ZaqueuCavalcante/egbit/Diagram.png

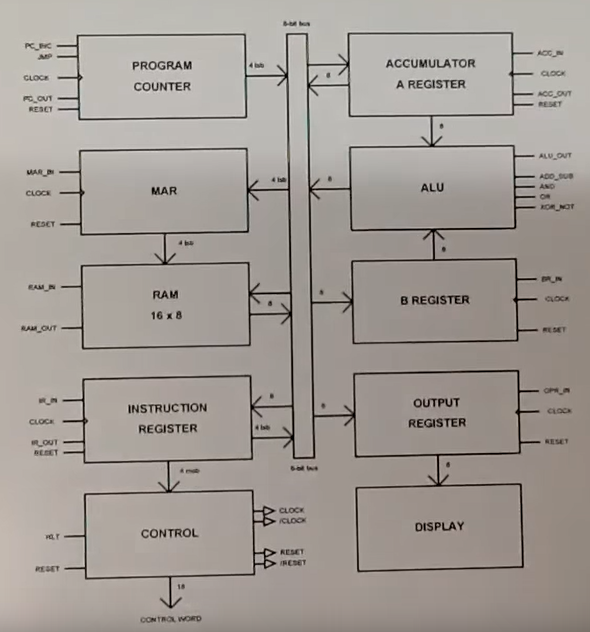
Diagram.png
