ZaqueuCavalcante/egbit/README.md

# Egbit

8 Bits Computer make from scratch.
