ZaqueuCavalcante/egbit/wr/8-bit_computer_00_WR_files/acc_register_list_WR_8-bit_computer.pdf

Bill Of Materials For ACC Register
Design Title | :ACC Register
Author | :<NONE>
Revision | :<NONE>
Design Created | :sexta-feira, 28 de julho de 2017
Design Last Modified:terça-feira, 15 de agosto de 2017 Total Parts In Design :22

8 Resistors

Quantity: | References | Value | Order Code
8 | R1-R8 | 470

3 Capacitors

Quantity: | References | Value | Order Code
3 | C1-C3 | 100nF

3 Integrated Circuits

Quantity: | References | Value | Order Code
2 | U1, U2 | 74LS173
1 | U3 | 74LS245

8 Diodes

Quantity: | References | Value | Order Code
8 | D1-D8 | LED

sexta-feira, 18 de agosto de 2017 18:22:33

Bill Of Materials For ACC Register | Página 1 de 1
file:///C:/Users/Usuário/AppData/Local/Temp/bom00001.HTM | 18/08/2017
