ZaqueuCavalcante/egbit/wr/8-bit_computer_00_WR_files/alu_list_WR_8-bit_computer.pdf

## Bill Of Materials For ALU

Design Title | :ALU
Author | | :<NONE>
Revision | | :<NONE>
Design Created | :terça-feira, 15 de agosto de 2017

### Design Last Modified:terça-feira, 29 de agosto de 2017 Total Parts In Design :50

### 8 Resistors

Quantity: | References | Value | Order Code
8 | R1-R8 | 470

### 17 Capacitors

Quantity: | References | Value | Order Code
17 | C1-C17 | 100nF

### 17 Integrated Circuits

Quantity: | References | Value | Order Code
2 | U1, U2 | 74LS283
4 | U3, U4, U10, U12 | 74LS86
2 | U5, U6 | 74LS08
4 | U7-U9, U11 | 74LS32
4 | U13-U16 | 74LS153
1 | U17 | 74LS245

### 8 Diodes

Quantity: | References | Value | Order Code
8 | D1-D8 | LED

sexta-feira, 15 de setembro de 2017 01:32:31

Bill Of Materials For ALU | Página 1 de 1
file:///C:/Users/Usuário/AppData/Local/Temp/bom00001.HTM | 15/09/2017
