ZaqueuCavalcante/egbit/wr/8-bit_computer_00_WR_files/clock_circuit_list_WR_8-bit_computer.pdf

## Bill Of Materials For Clock Circuit

Design Title | :Clock Circuit
Author | :<NONE>
Revision | :<NONE>
Design Created | :sexta-feira, 11 de agosto de 2017

### Design Last Modified:terça-feira, 15 de agosto de 2017 Total Parts In Design :19

### 5 Resistors

Quantity: | References | Value | Order Code
1 | R1 | 150
1 | R2 | 10
1 | R3 | 10k
1 | R4 | 330k
1 | R5 | 470

### 7 Capacitors

Quantity: | References | Value | Order Code
1 | C1 | 10uF | Maplin WW69A
2 | C2, C4 | 10nF
1 | C3 | 330nF
3 | C5-C7 | 100nF

### 3 Integrated Circuits

Quantity: | References | Value | Order Code
1 | U1 | NE556
1 | U2 | 74LS04
1 | U3 | 74LS00

### 1 Diodes

Quantity: | References | Value | Order Code
1 | D1 | LED

### 3 Miscellaneous

Quantity: | References | Value | Order Code
1 | CLK_MAN | buttom
1 | RV1 | 100k
1 | SW1 | SW-SPDT

terça-feira, 15 de agosto de 2017 00:34:17

Bill Of Materials For Clock Circuit | Página 1 de 1
file:///C:/Users/Usuário/AppData/Local/Temp/bom00001.HTM | 15/08/2017
