ZaqueuCavalcante/egbit/wr/8-bit_computer_00_WR_files/control_decoder_list_WR_8-bit_computer.pdf

Bill Of Materials For Control Decoder
Design Title | :Control Decoder
Author | :<NONE>
Revision | :<NONE>
Design Created | :sexta-feira, 28 de julho de 2017
Design Last Modified:segunda-feira, 30 de outubro de 2017 Total Parts In Design :6

3 Capacitors

Quantity: | References | Value | Order Code
3 | C1-C3 | 100nF

3 Integrated Circuits

Quantity: | References | Value | Order Code
3 | U1-U3 | 2816

segunda-feira, 30 de outubro de 2017 23:34:38

Bill Of Materials For Control Decoder | Página 1 de 1
file:///C:/Users/Usuário/AppData/Local/Temp/bom00001.HTM | 30/10/2017
