ZaqueuCavalcante/egbit/wr/8-bit_computer_00_WR_files/control_word_list_WR_8-bit_computer.pdf

Bill Of Materials For Control Word
Design Title | :Control Word
Author | :<NONE>
Revision | :<NONE>
Design Created | :sexta-feira, 28 de julho de 2017
Design Last Modified:quinta-feira, 26 de outubro de 2017 Total Parts In Design :40

18 Resistors

Quantity: | References | Value | Order Code
18 | R1-R18 | 3k

2 Capacitors

Quantity: | References | Value | Order Code
2 | C1, C2 | 100nF

2 Integrated Circuits

Quantity: | References | Value | Order Code
2 | U1, U2 | 74LS04

18 Diodes

Quantity: | References | Value | Order Code
18 | D1-D18 | LED

segunda-feira, 30 de outubro de 2017 23:36:12

Bill Of Materials For Control Word | Página 1 de 1
file:///C:/Users/Usuário/AppData/Local/Temp/bom00001.HTM | 30/10/2017
