ZaqueuCavalcante/egbit/wr/8-bit_computer_00_WR_files/Cores e tamanhos dos LEDs de cada circuito.pdf

Cores e tamanhos dos LEDs de cada circuito

ACC Register: 8 LEDs vermelhos 3mm difusos;

ALU: 8 LEDs vermelhos 3mm difusos;

B Register: 8 LEDs vermelhos 3mm difusos;

Clock Circuit: 1 LED verde 5mm difuso;

Control Word: 18 LEDs azuis 3mm difusos;

Fetch Execution Counter: 3 LEDs amarelos 3mm difusos e 5 LEDs verdes 3mm difusos;

Instruction Register: 4 LEDs verdes 3mm difusos e 4 LEDs vermelhos 3mm difusos;

Output Register: 8 LEDs amarelos 3mm difusos;

Program Counter: 4 LEDs verdes 3mm difusos;

RAM & MAR: 4 LEDs amarelos 3mm difusos, 9 LEDs vermelhos 3mm difusos e 1 LED verde 3mm difuso;

BUS: 8 LEDs azuis 3mm difusos.
