ZaqueuCavalcante/egbit/wr/8-bit_computer_00_WR_files/decimal_display_list_WR_8-bit_computer.pdf

## Bill Of Materials For Decimal Display

Design Title | :Decimal Display
Author | :<NONE>
Revision | :<NONE>
Design Created | :sexta-feira, 28 de julho de 2017

### Design Last Modified:quinta-feira, 28 de setembro de 2017 Total Parts In Design :13

### 2 Resistors

Quantity: | References | Value | Order Code
1 | R1 | 1k
1 | R2 | 100k

### 5 Capacitors

Quantity: | References | Value | Order Code
3 | C1-C3 | 100nF
1 | C4 | 15nF
1 | C5 | 10nF

### 4 Integrated Circuits

Quantity: | References | Value | Order Code
1 | U1 | 2816
1 | U2 | 555
1 | U3 | 74LS161
1 | U4 | 74LS139

### 2 Miscellaneous

Quantity: | References | Value | Order Code
1 | DISPLAY | XDMR14C4-1A
1 | SW1 | SW-SPDT

quinta-feira, 28 de setembro de 2017 15:53:52

Bill Of Materials For Decimal Display | Página 1 de 1
file:///C:/Users/Usuário/AppData/Local/Temp/bom00001.HTM | 28/09/2017
