ZaqueuCavalcante/egbit/wr/8-bit_computer_00_WR_files/fetch_execution_counter_list_WR_8-bit_computer.pdf

Bill Of Materials For Fetch Execution Counter
Design Title | :Fetch Execution Counter
Author | :<NONE>
Revision | :<NONE>
Design Created | :sexta-feira, 28 de julho de 2017
Design Last Modified:quarta-feira, 4 de outubro de 2017 Total Parts In Design :15

3 Resistors

Quantity: | References | Value | Order Code
3 | R2, R3, R9 | 330

2 Capacitors

Quantity: | References | Value | Order Code
2 | C1, C2 | 100nF

2 Integrated Circuits

Quantity: | References | Value | Order Code
1 | U1 | 74LS161
1 | U2 | 74LS138

8 Diodes

Quantity: | References | Value | Order Code
8 | D1-D8 | LED

quarta-feira, 4 de outubro de 2017 17:11:42

Bill Of Materials For Fetch Execution Counter | Página 1 de 1
file:///C:/Users/Usuário/AppData/Local/Temp/bom00001.HTM | 04/10/2017
