ZaqueuCavalcante/egbit/wr/8-bit_computer_00_WR_files/output_register_list_WR_8-bit_computer.pdf

Bill Of Materials For Output Register
Design Title | :Output Register
Author | :<NONE>
Revision | :<NONE>
Design Created | :sexta-feira, 28 de julho de 2017
Design Last Modified:sexta-feira, 22 de setembro de 2017 Total Parts In Design :20

8 Resistors

Quantity: | References | Value | Order Code
8 | R1-R8 | 150

2 Capacitors

Quantity: | References | Value | Order Code
2 | C1, C2 | 100nF

2 Integrated Circuits

Quantity: | References | Value | Order Code
2 | U1, U2 | 74LS173

8 Diodes

Quantity: | References | Value | Order Code
8 | D1-D8 | LED

segunda-feira, 25 de setembro de 2017 12:48:52

Bill Of Materials For Output Register | Página 1 de 1
file:///C:/Users/Usuário/AppData/Local/Temp/bom00001.HTM | 25/09/2017
