ZaqueuCavalcante/egbit/wr/8-bit_computer_00_WR_files/program_counter_list_WR_8-bit_computer.pdf

Bill Of Materials For Program Counter
Design Title | :Program Counter
Author | :<NONE>
Revision | :<NONE>
Design Created | :terça-feira, 15 de agosto de 2017
Design Last Modified:terça-feira, 15 de agosto de 2017 Total Parts In Design :12

4 Resistors

Quantity: | References | Value | Order Code
4 | R1-R4 | 470

2 Capacitors

Quantity: | References | Value | Order Code
2 | C1, C2 | 100nF

2 Integrated Circuits

Quantity: | References | Value | Order Code
1 | U1 | 74LS161
1 | U2 | 74LS245

4 Diodes

Quantity: | References | Value | Order Code
4 | D1-D4 | LED

terça-feira, 15 de agosto de 2017 17:18:45

Bill Of Materials For Program Counter | Página 1 de 1
file:///C:/Users/Usuário/AppData/Local/Temp/bom00001.HTM | 15/08/2017
