ZaqueuCavalcante/egbit/wr/8-bit_computer_00_WR_files/reset_circuit_list_WR_8-bit_computer.pdf

Bill Of Materials For Reset Circuit
Design Title | :Reset Circuit
Author | :<NONE>
Revision | :<NONE>
Design Created | :sexta-feira, 28 de julho de 2017
Design Last Modified:sábado, 23 de setembro de 2017 Total Parts In Design :4

1 Resistors

Quantity: | References | Value | Order Code
1 | R1 | 10k

1 Capacitors

Quantity: | References | Value | Order Code
1 | C1 | 100nF

1 Integrated Circuits

Quantity: | References | Value | Order Code
1 | U1 | 74LS00

1 Miscellaneous

Quantity: | References | Value | Order Code
1 | BT_RST

segunda-feira, 25 de setembro de 2017 12:51:08

Bill Of Materials For Reset Circuit | Página 1 de 1
file:///C:/Users/Usuário/AppData/Local/Temp/bom00001.HTM | 25/09/2017
