ZaqueuCavalcante/egbit/wr/8-bit_computer_00_WR_files/other_components_and_parts_list_WR_8-bit.pdf

Bill Of Materials For Other Components And Parts
Design Title | :Other Components and Parts
Author | | :<NONE>
Revision | | :<NONE>
Design Created | :sexta-feira, 28 de julho de 2017
Design Last Modified:segunda-feira, 30 de outubro de 2017 Total Parts In Design :37

8 Resistors

Quantity: | References | Value | Order Code
8 | R1-R8 | 1k

8 Diodes

Quantity: | References | Value | Order Code
8 | D1-D8 | LED

21 Miscellaneous

Quantity: | References | Value | Order Code
18 | OT1-OT18 | PROTOBOARD
1 | OT19 | MUITOS FIOS 22AWG
1 | OT20 | CHAPA_PVC 37X37CM
1 | RP1 | RESPACK-8x10k

segunda-feira, 30 de outubro de 2017 23:55:25

Bill Of Materials For Other Components and Parts | Página 1 de 1
file:///C:/Users/Usuário/AppData/Local/Temp/bom00001.HTM | 30/10/2017
