ZaqueuCavalcante/egbit/00_clock_circuit.PDF

U1:A

U1:B

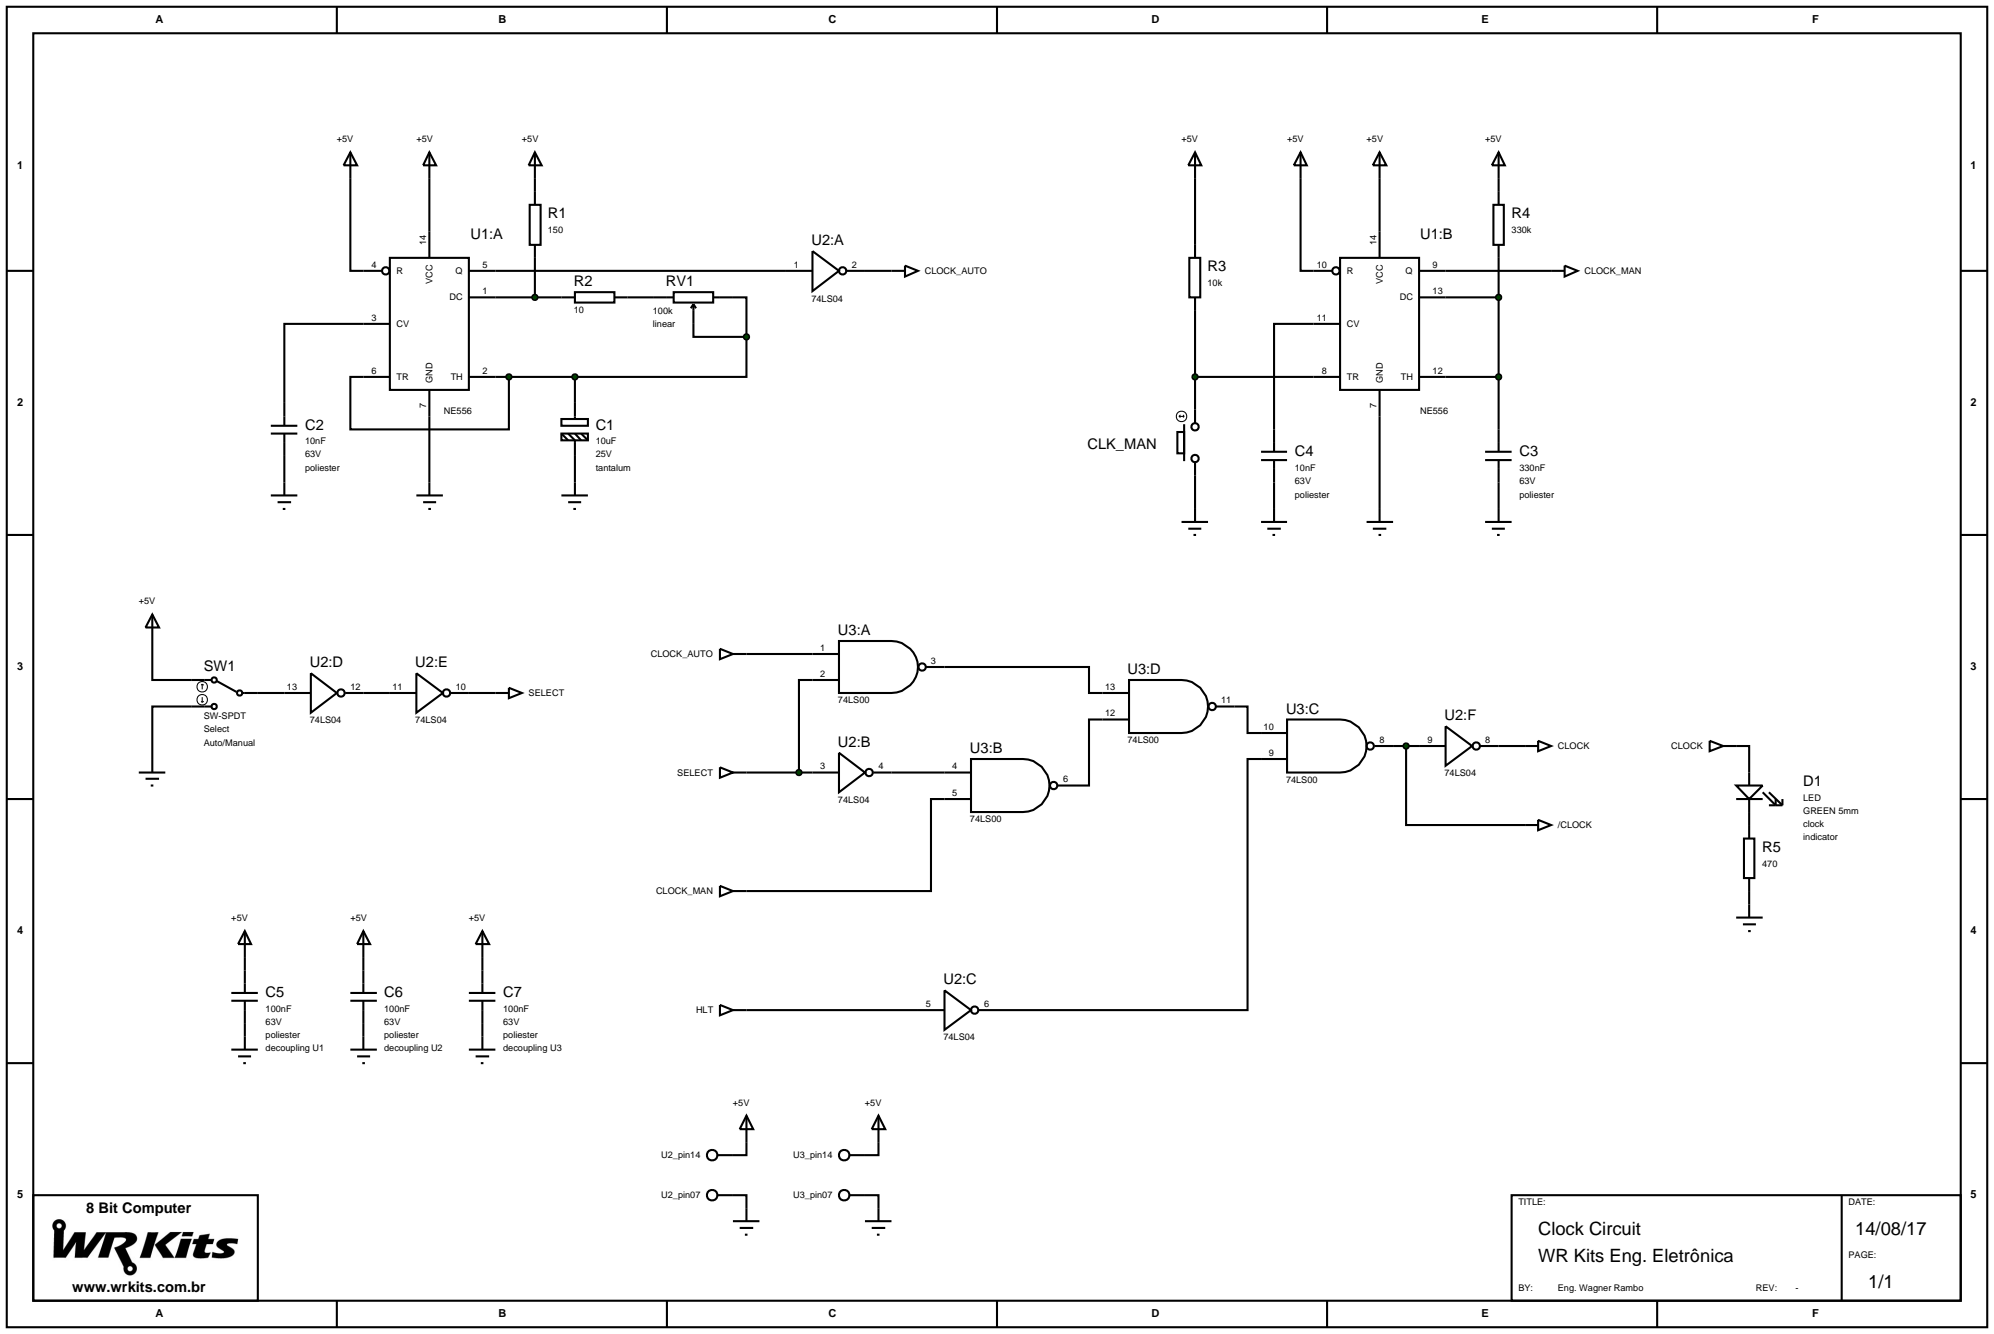
[picture p5: page 1]

TITLE:
Clock Circuit
WR Kits Eng. Eletrônica

www.wrkits.com.br
