ZaqueuCavalcante/egbit/reset_circuit_WR_8-bit_computer.PDF

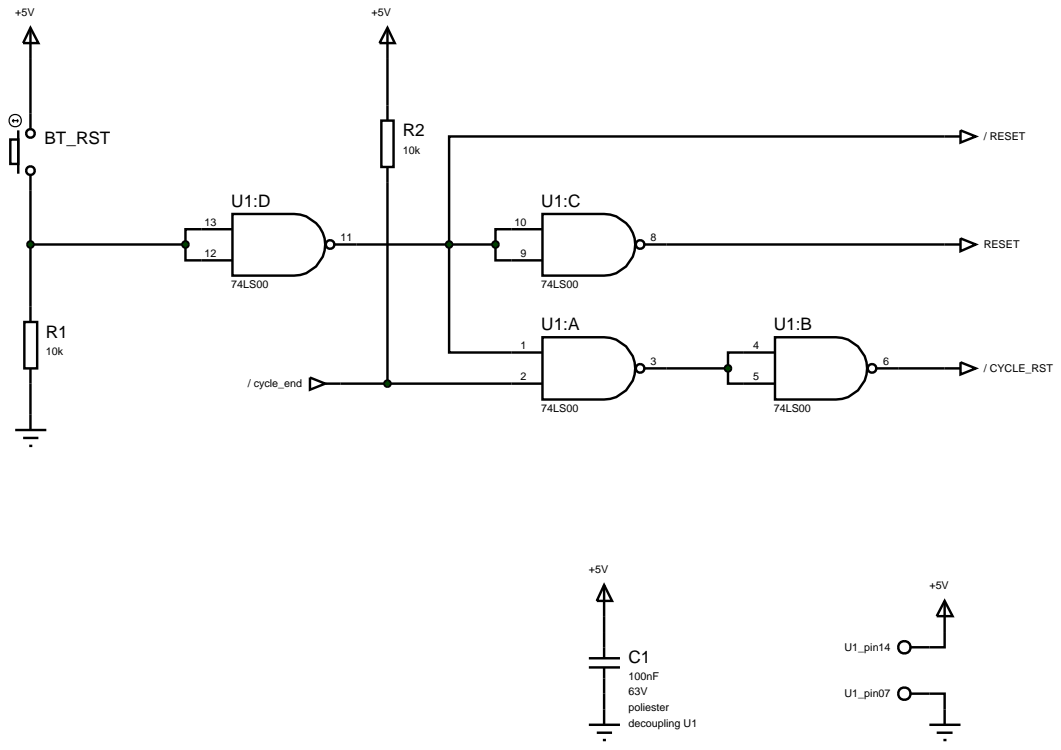
[picture p6: page 1]
DATE:; PAGE:; Eng. Wagner Rambo; REV:; 8 Bit Computer; 100nF 63V poliester decoupling U1; RESET; / RESET; / CYCLE_RST; / cycle_end; BT_RST; U1_pin14; U1_pin07

TITLE:
Reset Circuit
WR Kits Eng. Eletrônica

www.wrkits.com.br
