ZaqueuCavalcante/egbit/wr/8-bit_computer_02_WR_files/clock_circuit_WR_8-bit_computer.PDF

U1:A

U1:B


TITLE:
Clock Circuit
WR Kits Eng. Eletrônica

www.wrkits.com.br
