ZaqueuCavalcante/egbit/04_instruction_register.PDF

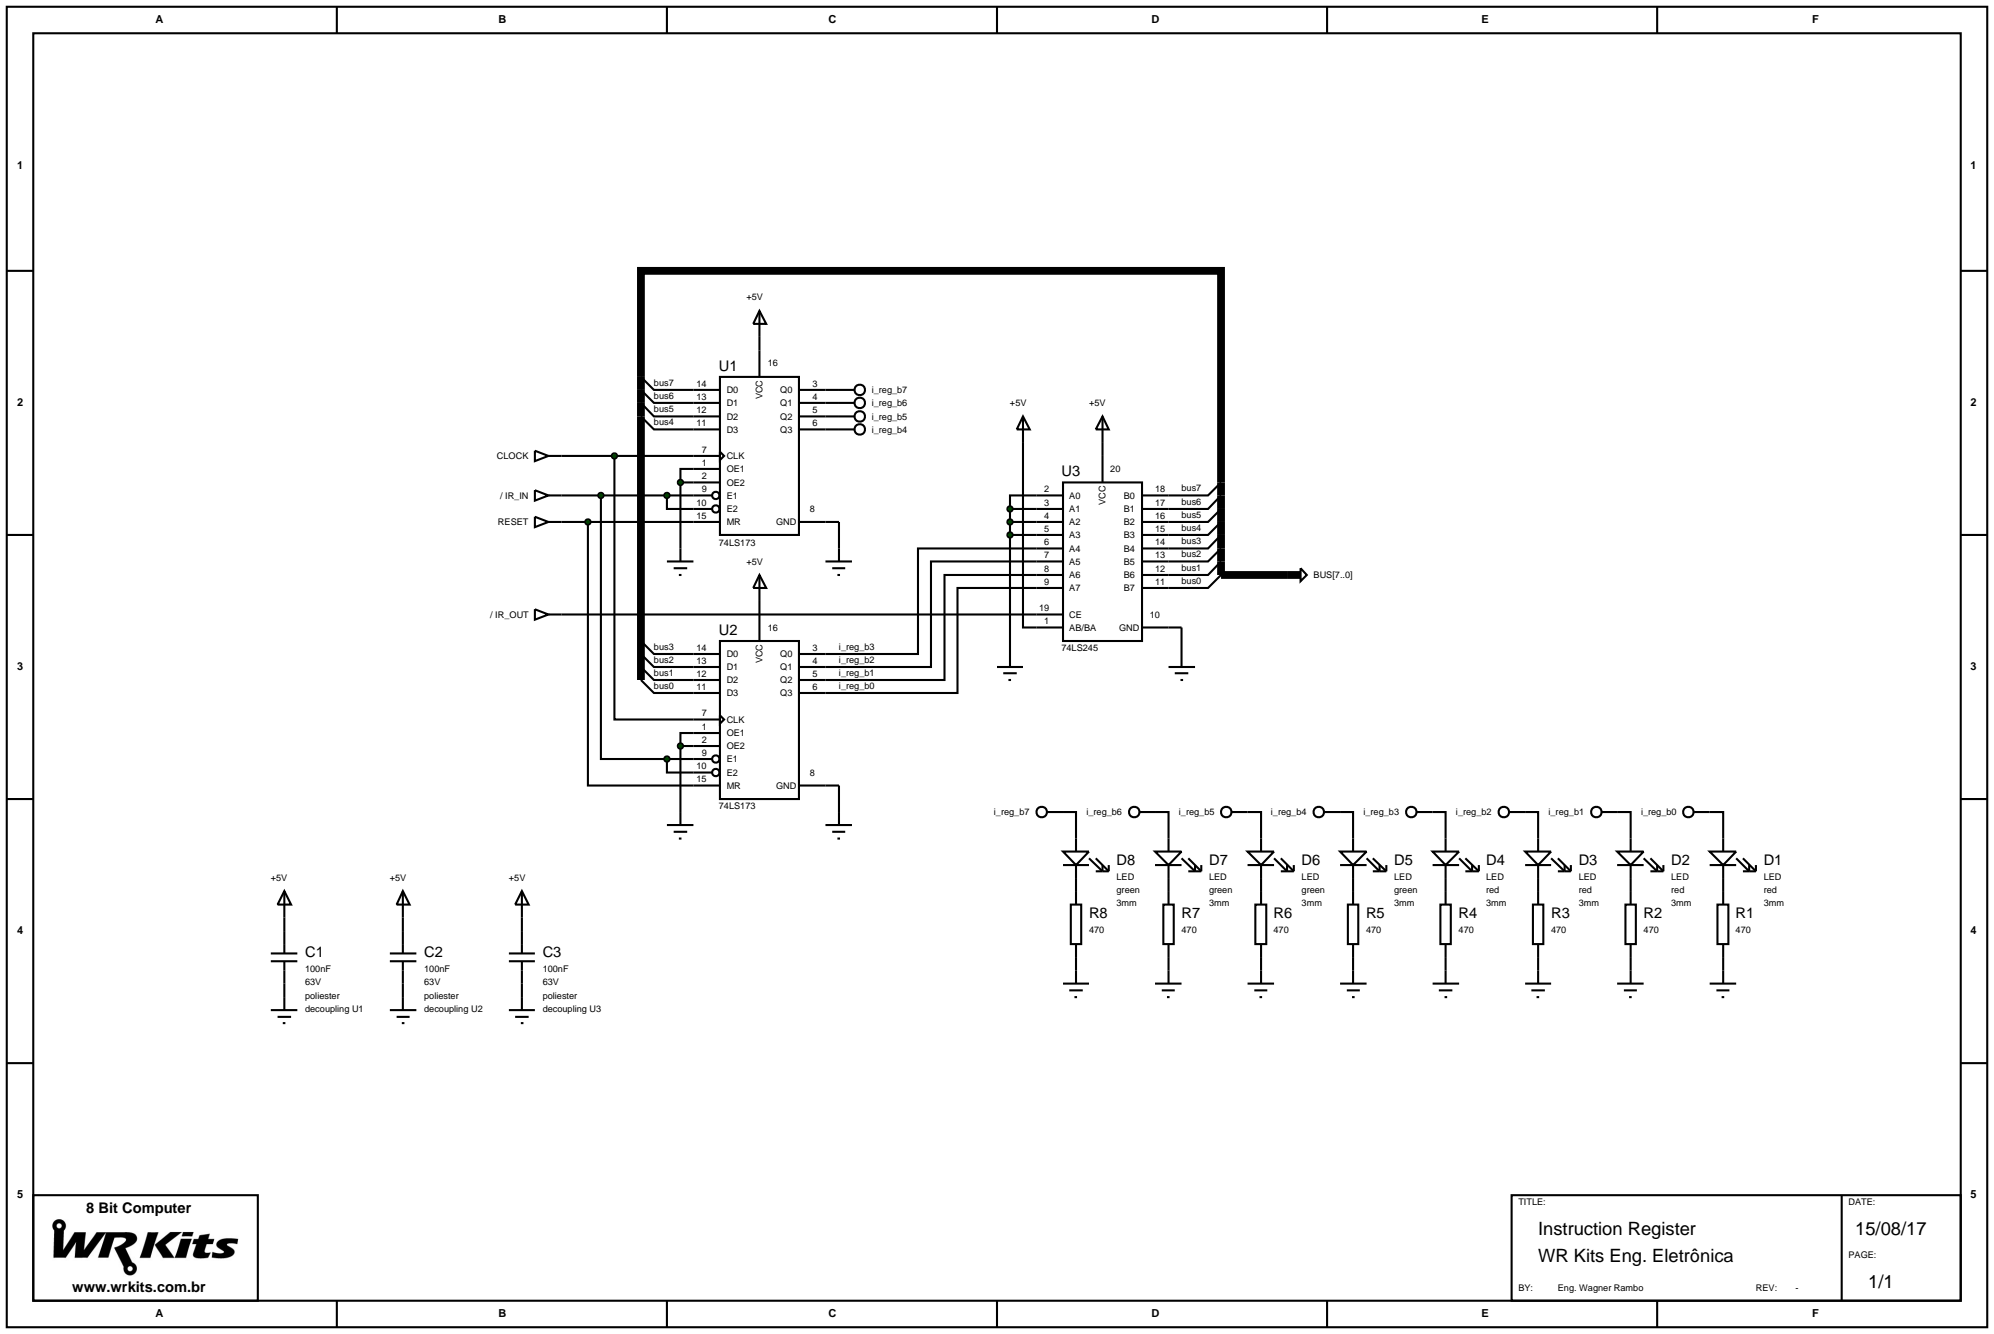
[picture p7: page 1]

TITLE:
Instruction Register
WR Kits Eng. Eletrônica

www.wrkits.com.br
