ZaqueuCavalcante/egbit/02_acc_register.PDF

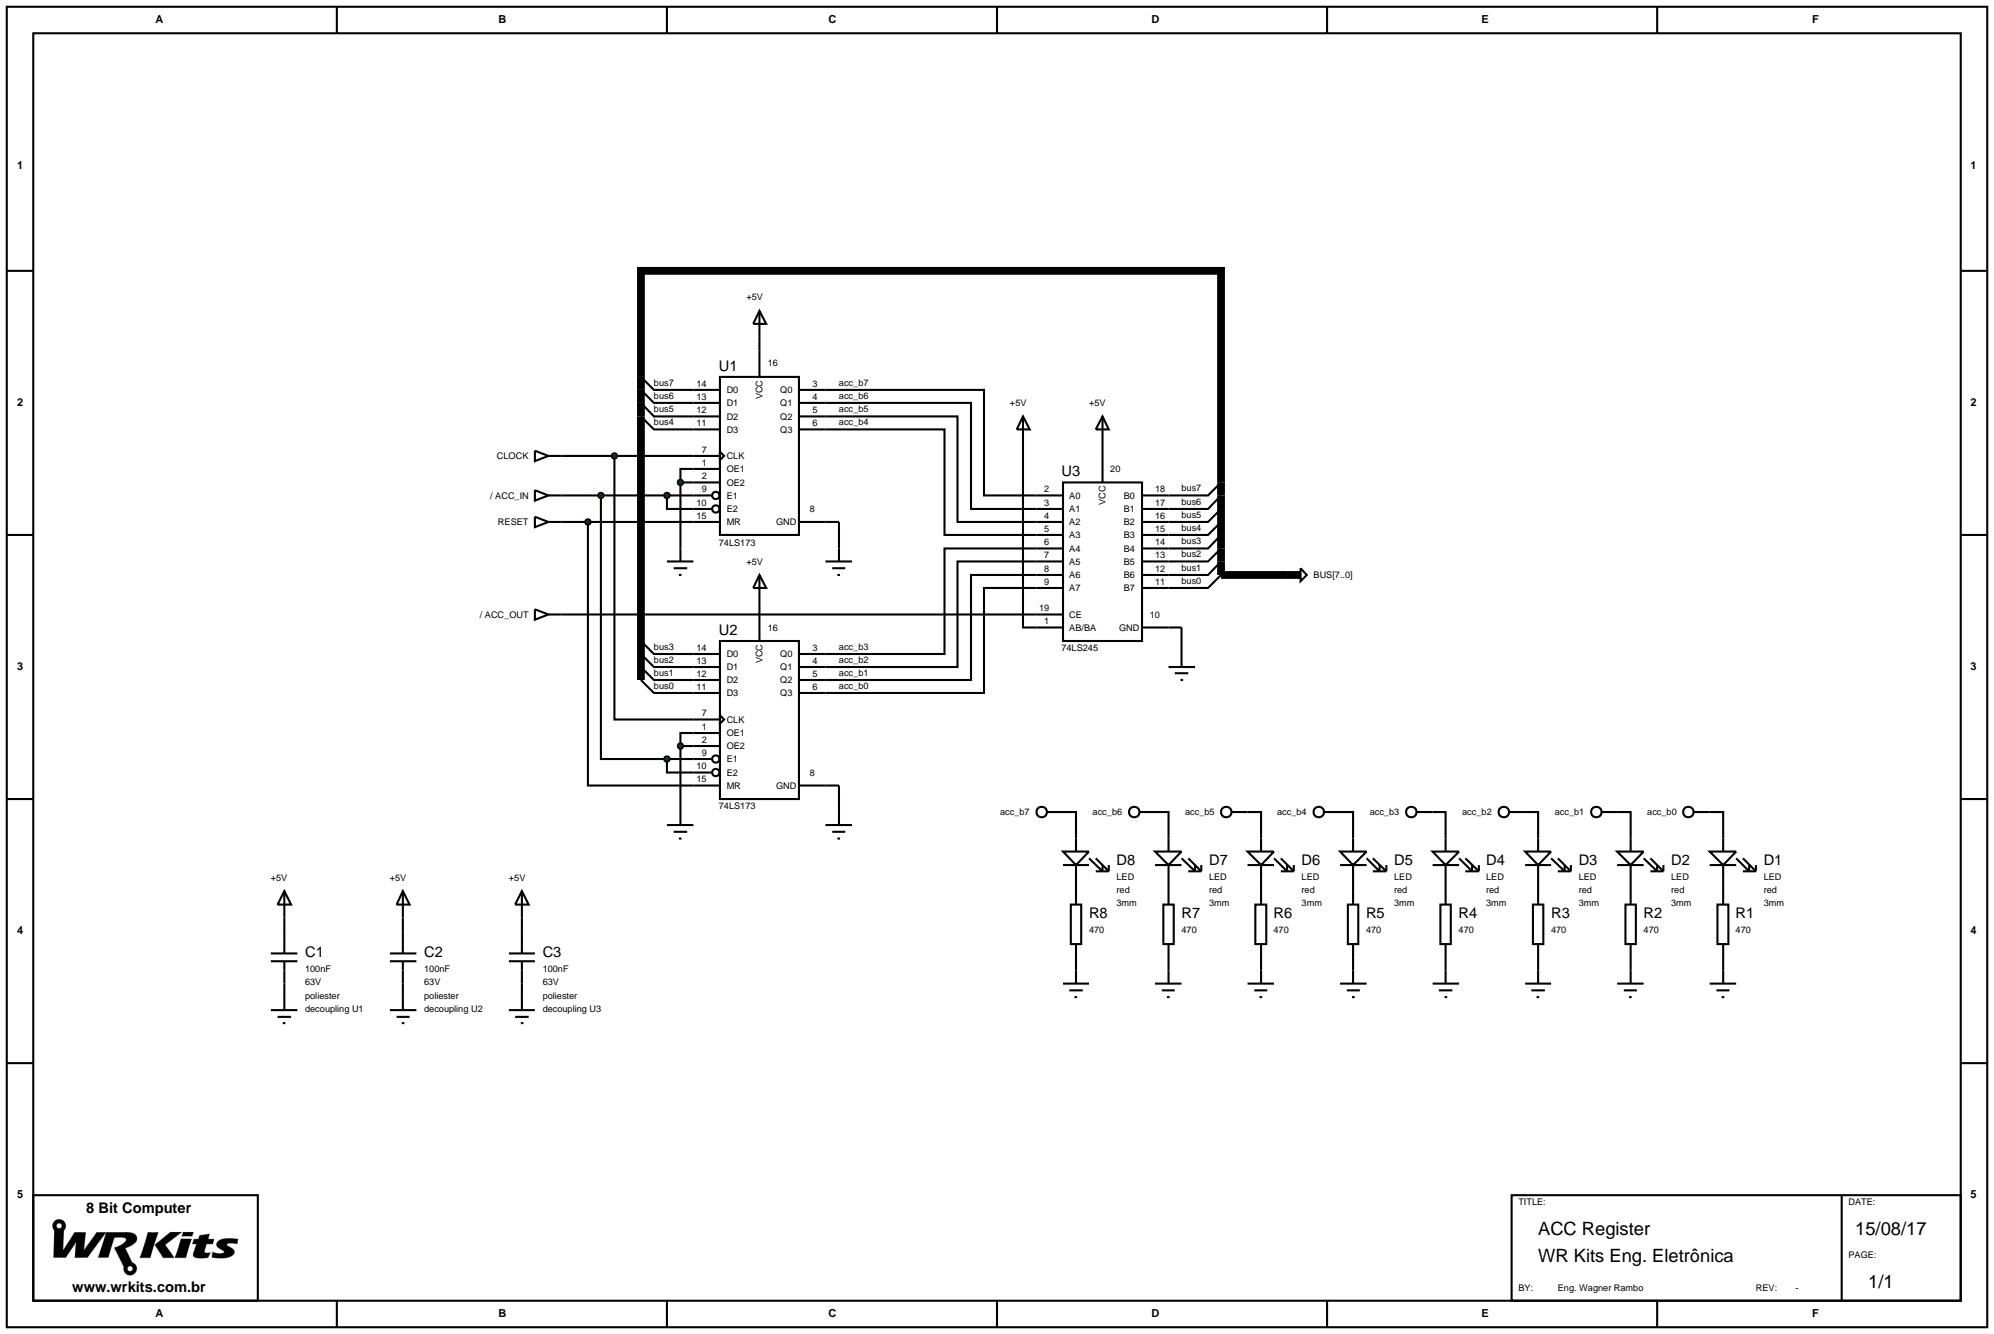
[picture p8: page 1]

TITLE:
ACC Register
WR Kits Eng. Eletrônica

www.wrkits.com.br
