ZaqueuCavalcante/egbit/03_b_register.PDF

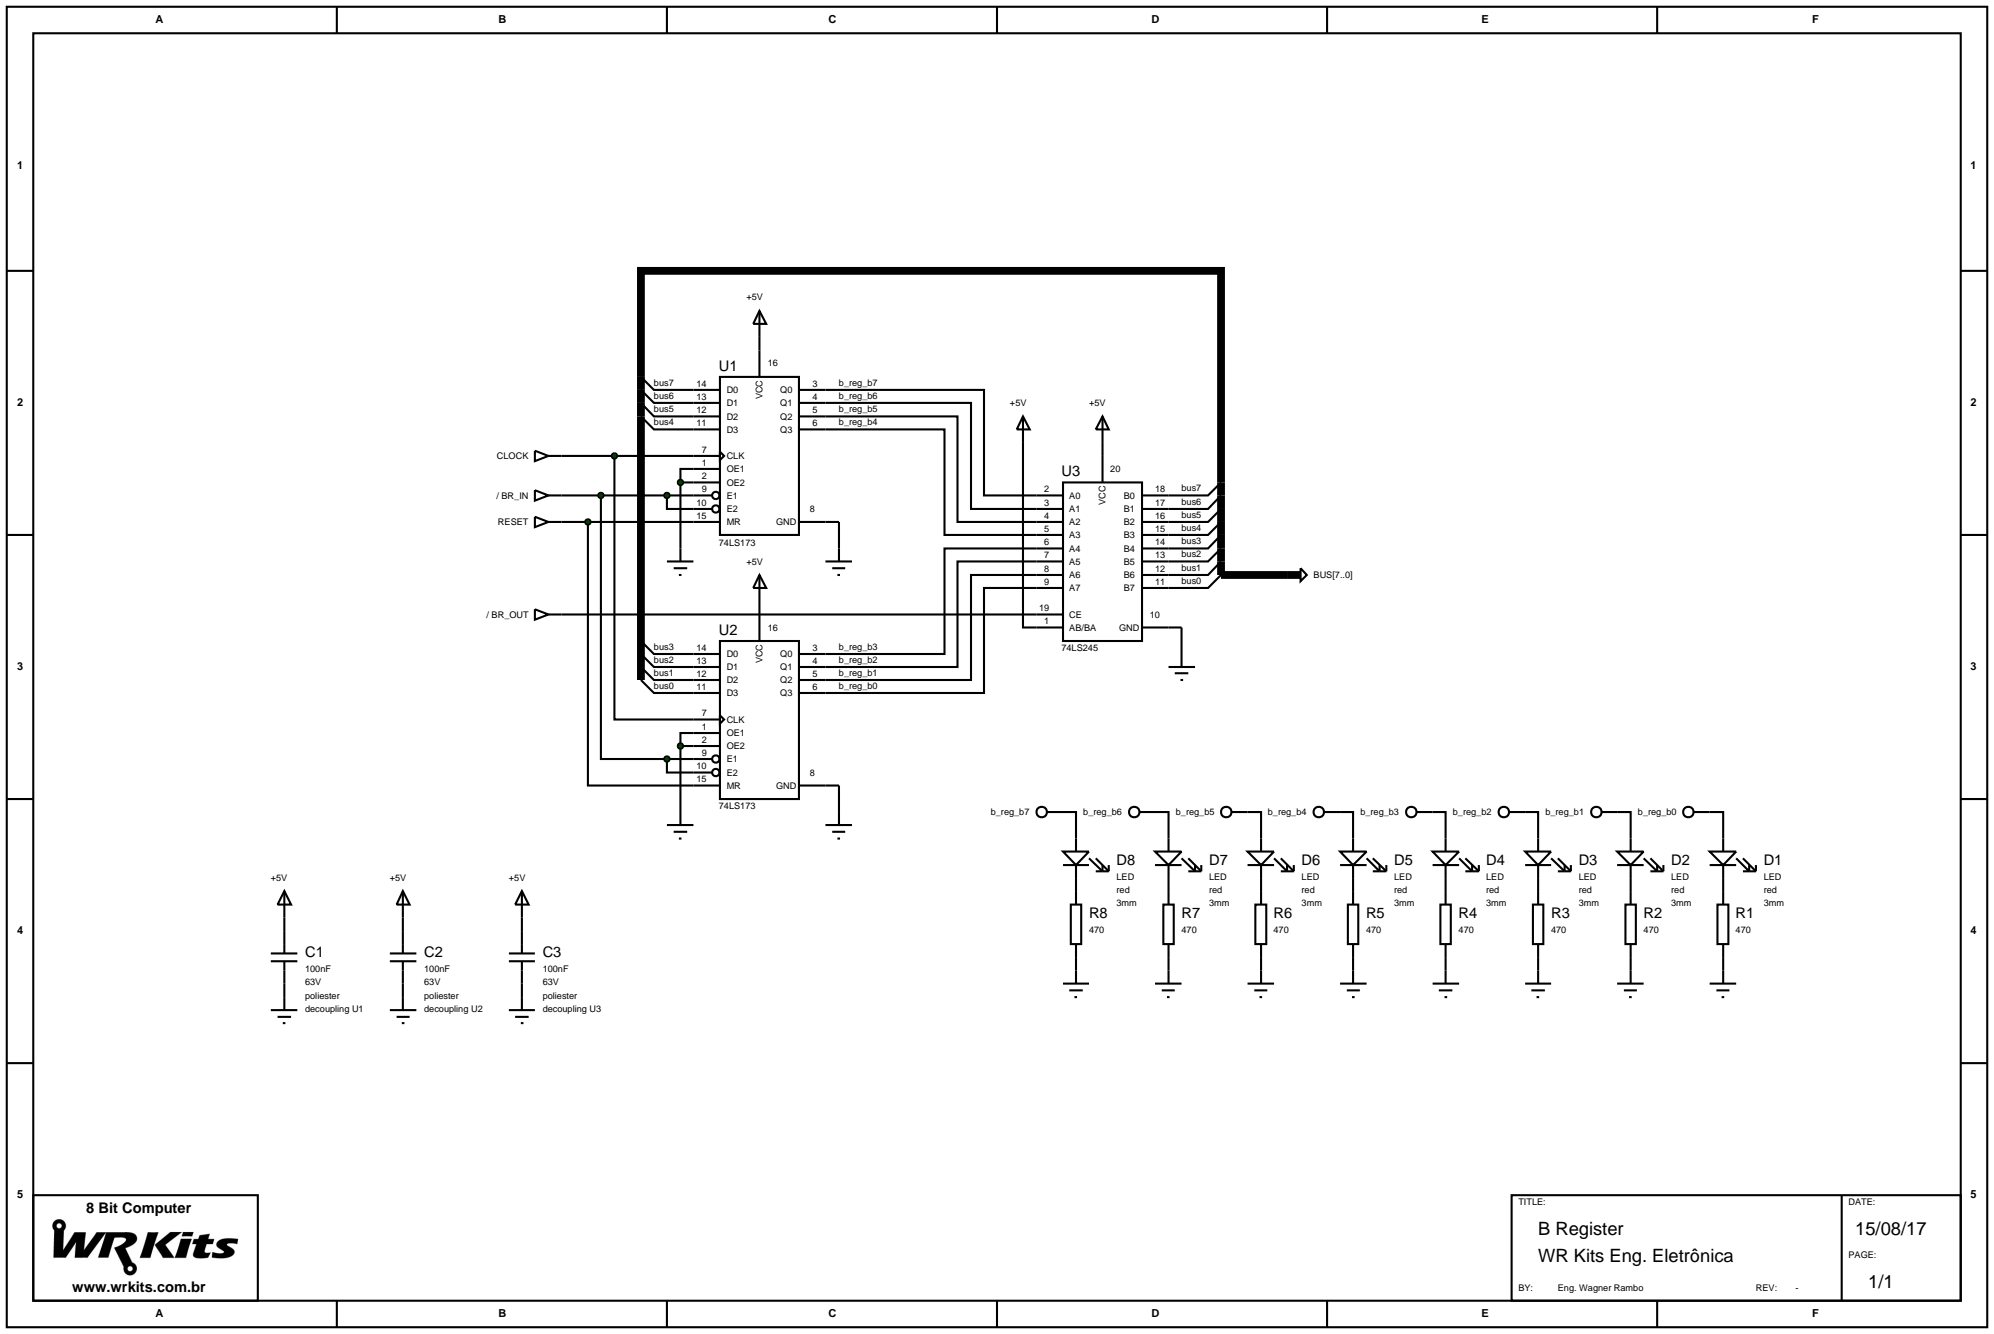
[picture p9: page 1]

TITLE:
B Register
WR Kits Eng. Eletrônica

www.wrkits.com.br
