ZaqueuCavalcante/egbit/05_alu.PDF

U1

U2

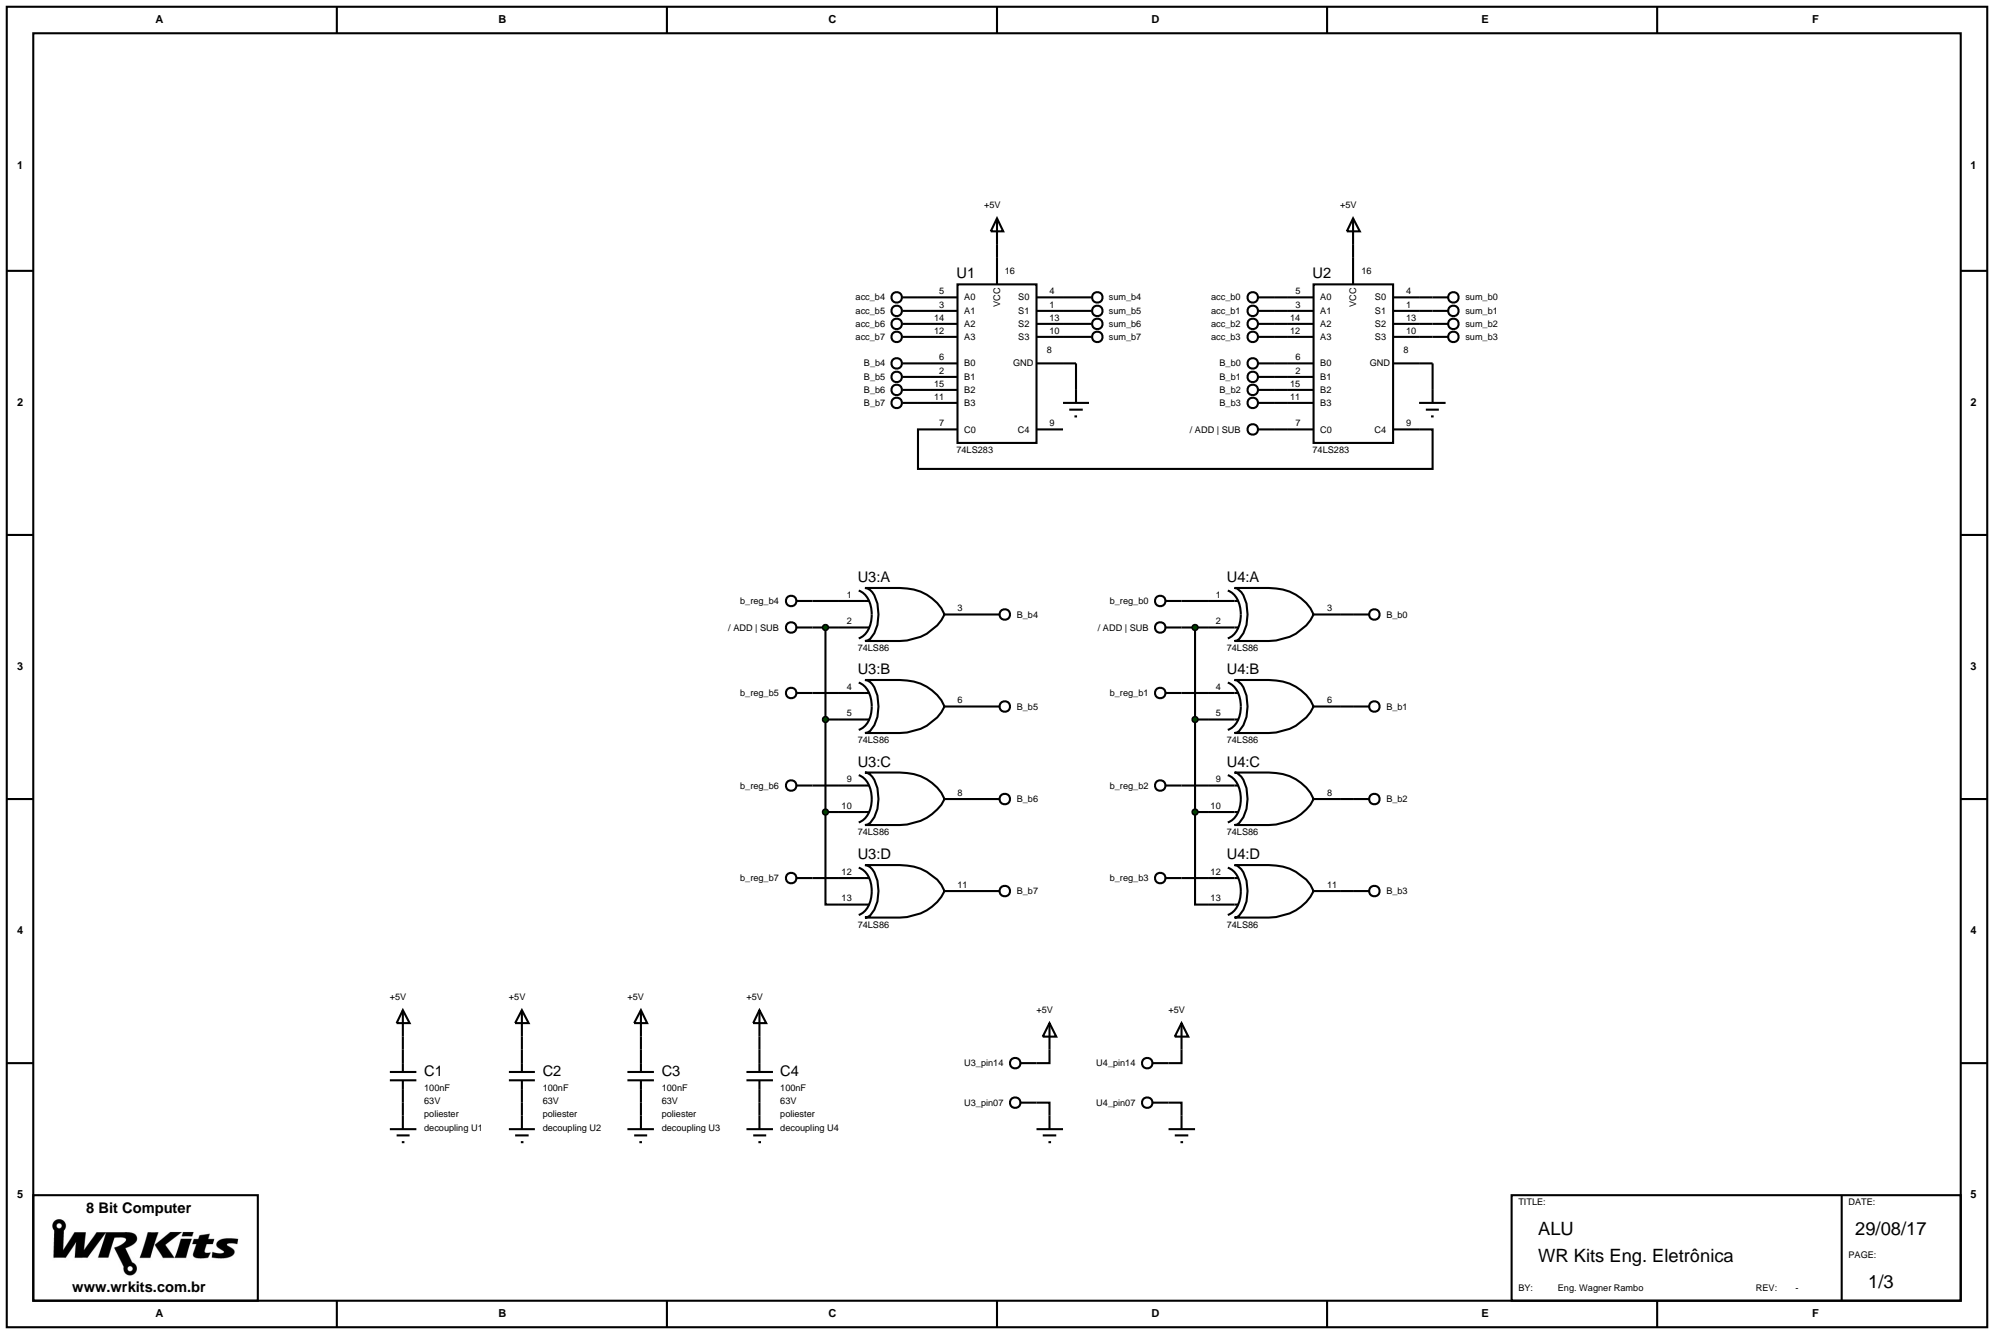
[picture p10: page 1]

TITLE:
ALU
WR Kits Eng. Eletrônica

www.wrkits.com.br

U5:A

U5:B

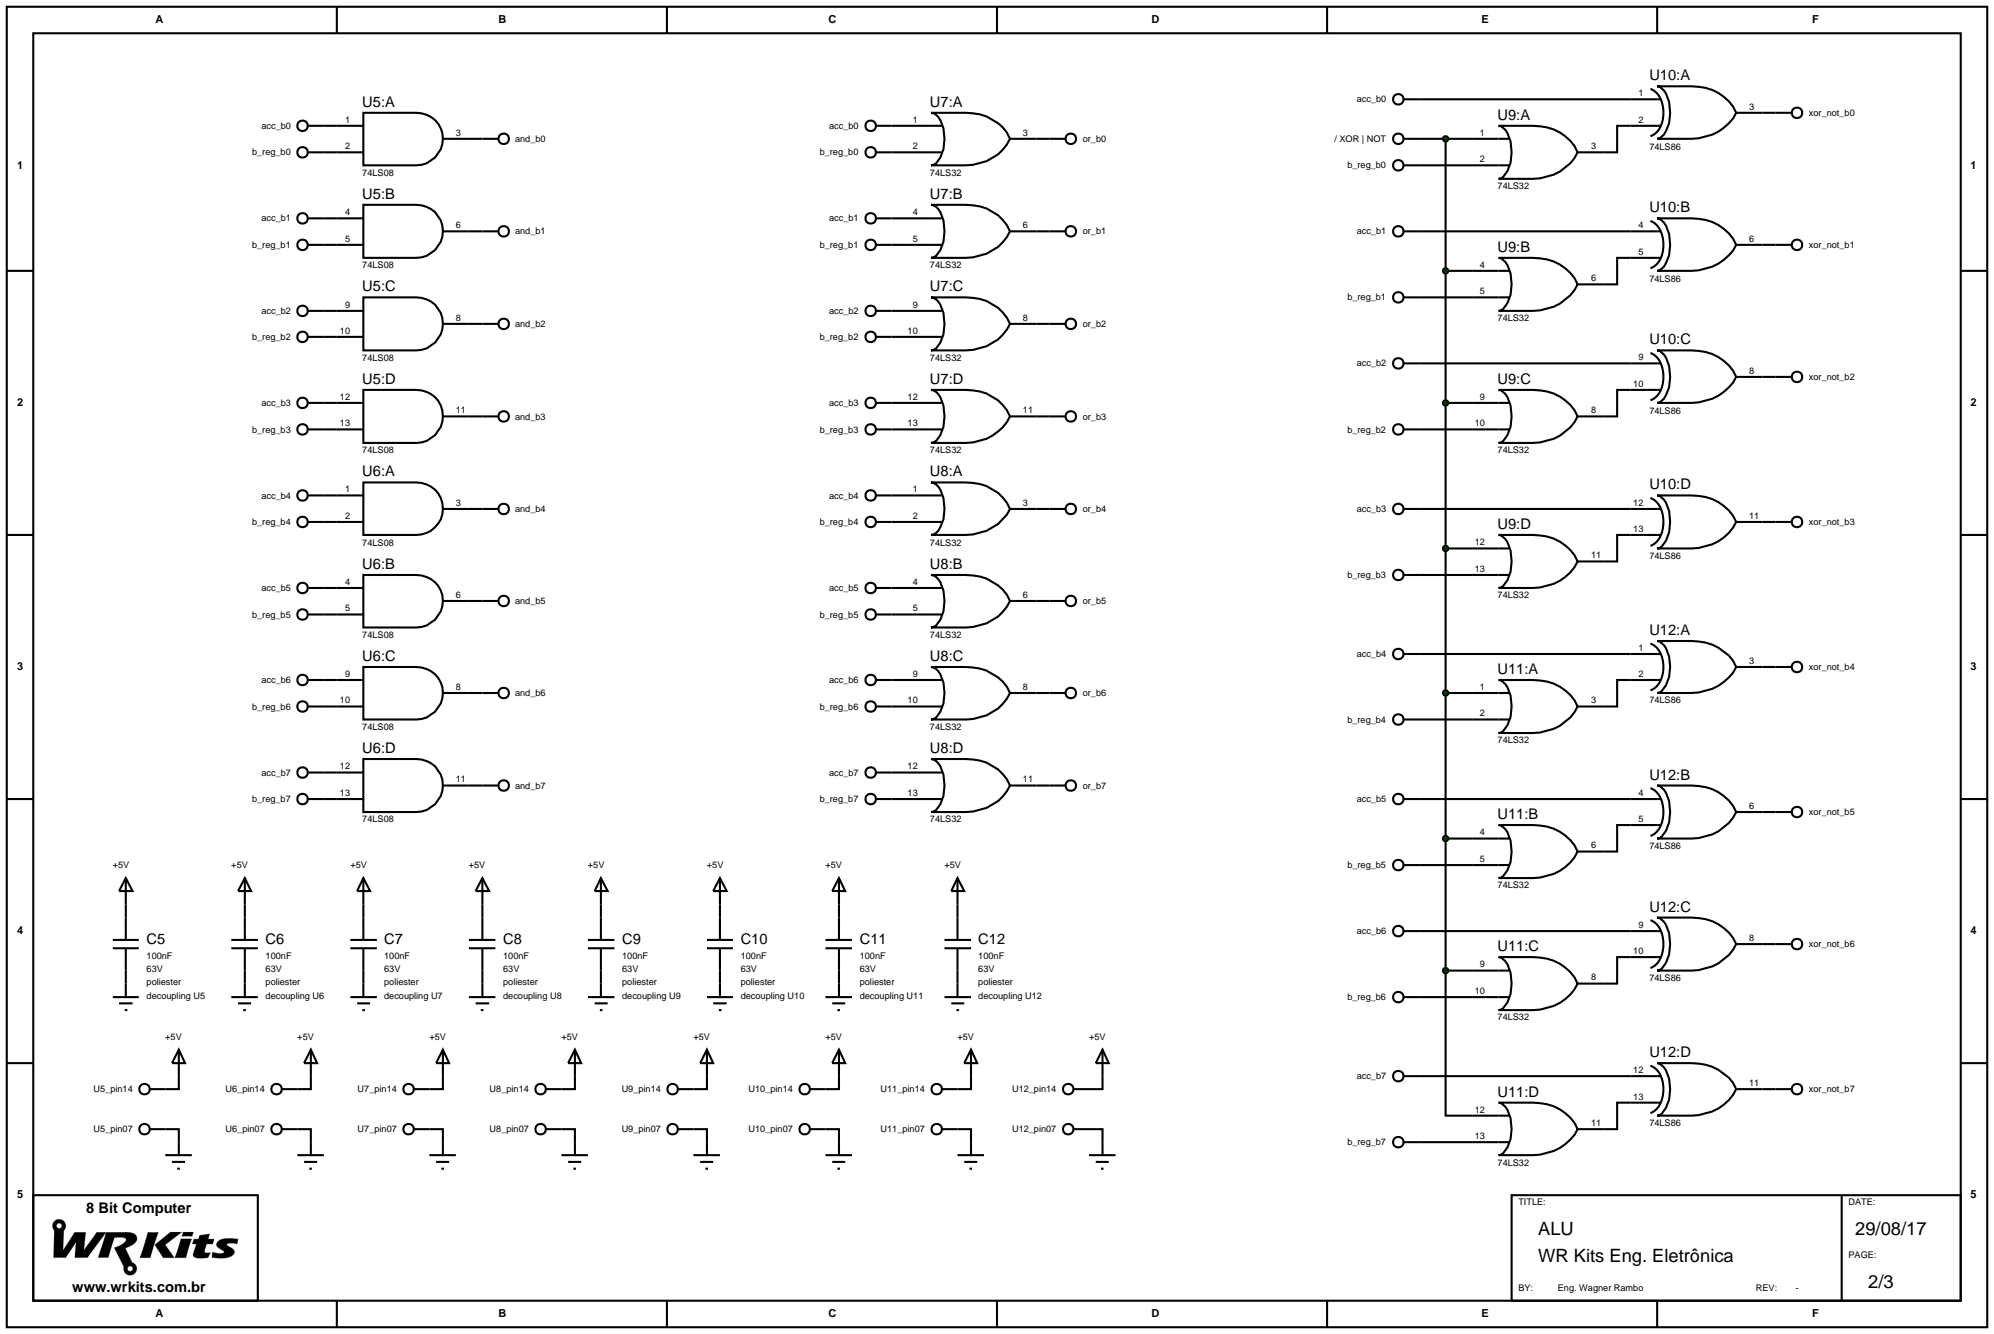
[picture p11: page 2]

U13

U15

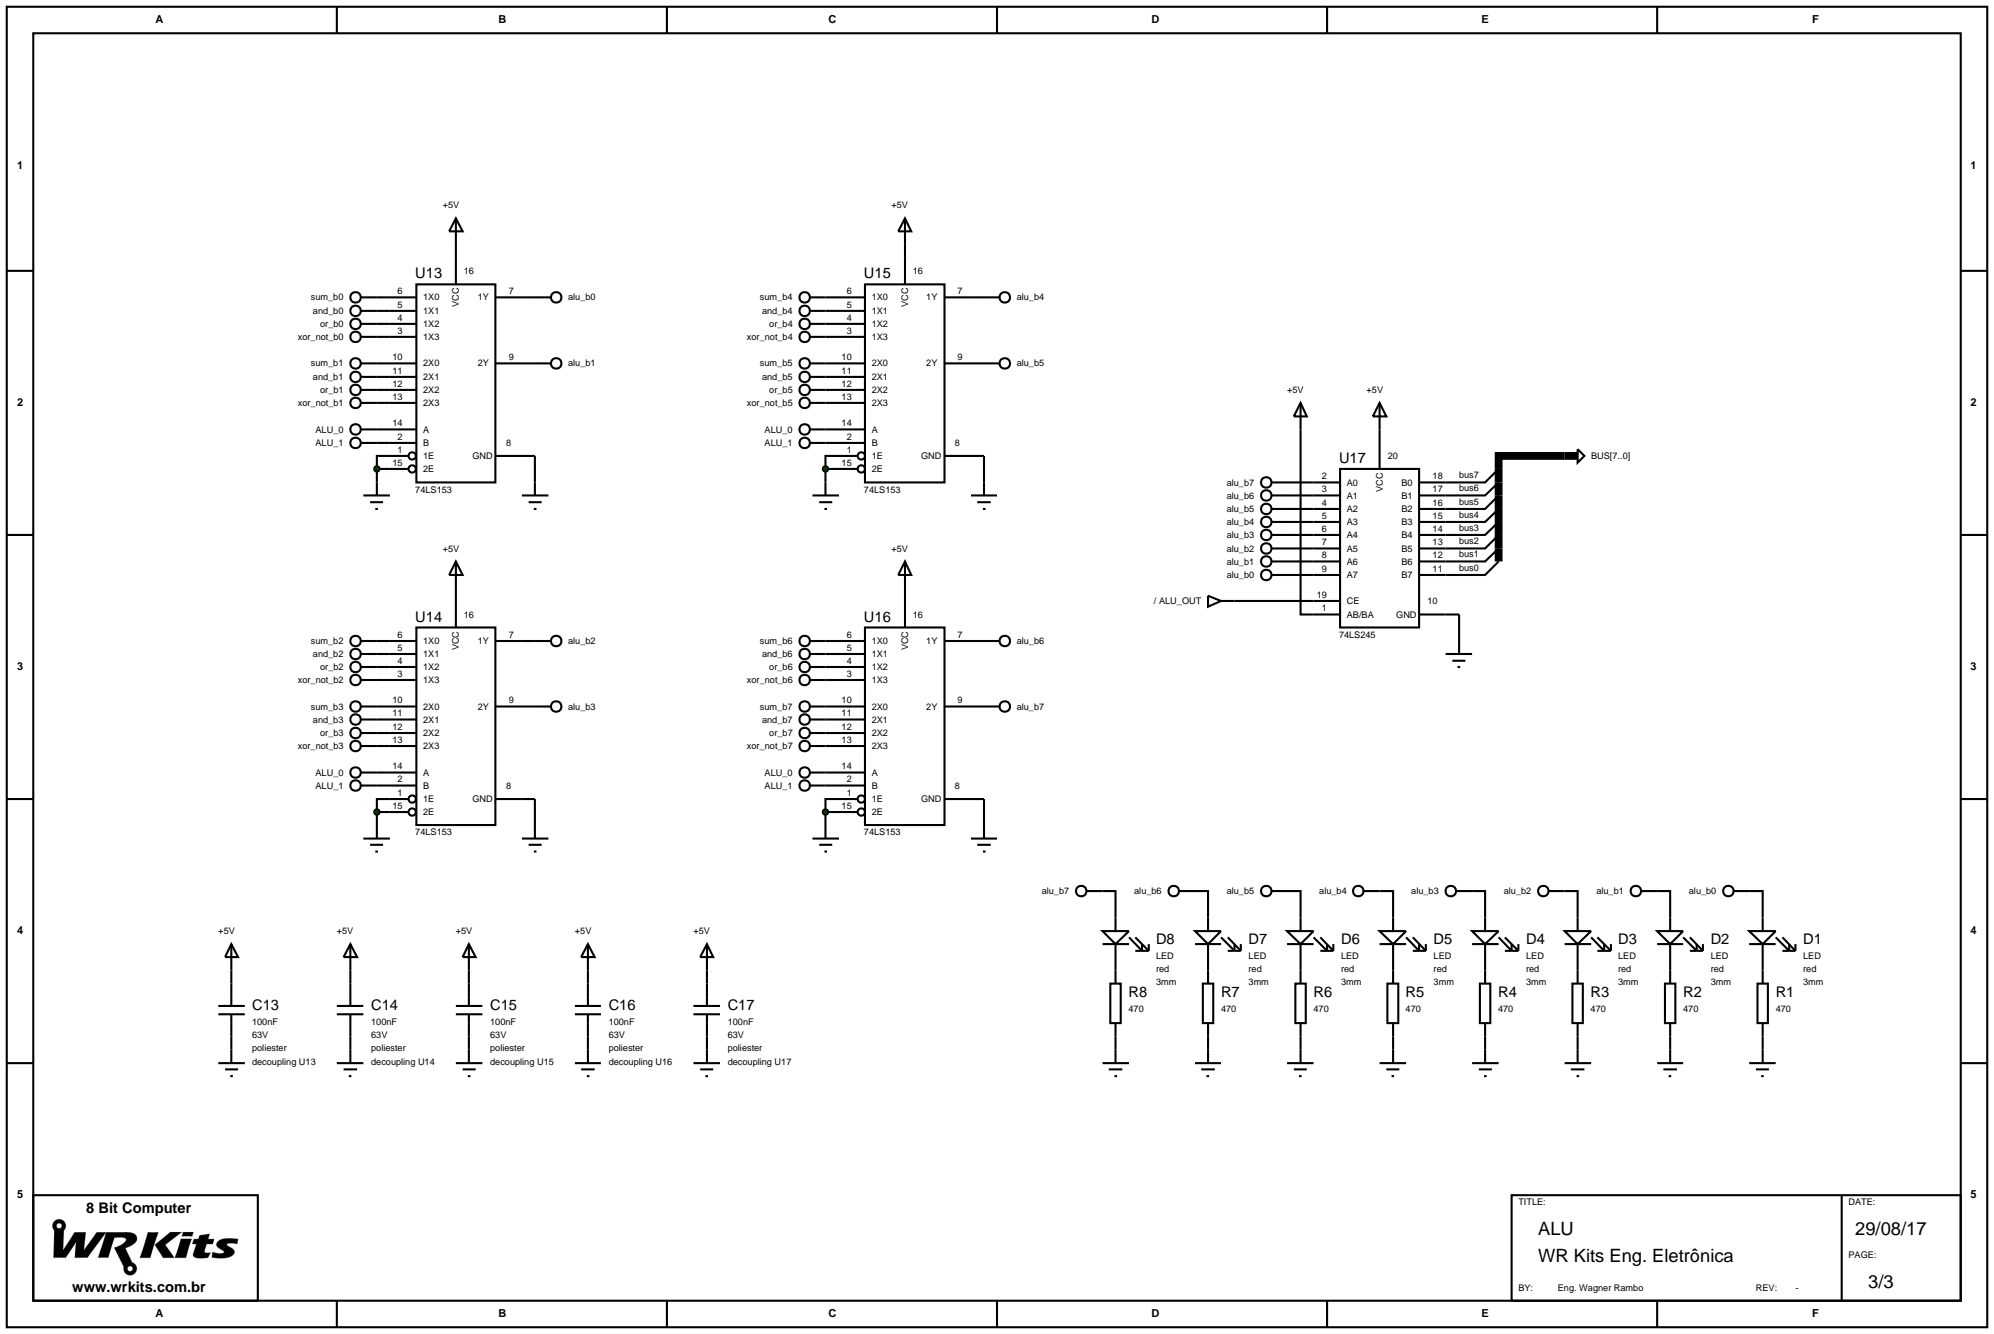
[picture p12: page 3]
