ZaqueuCavalcante/egbit/06_RAM_MAR.PDF

U1

U2

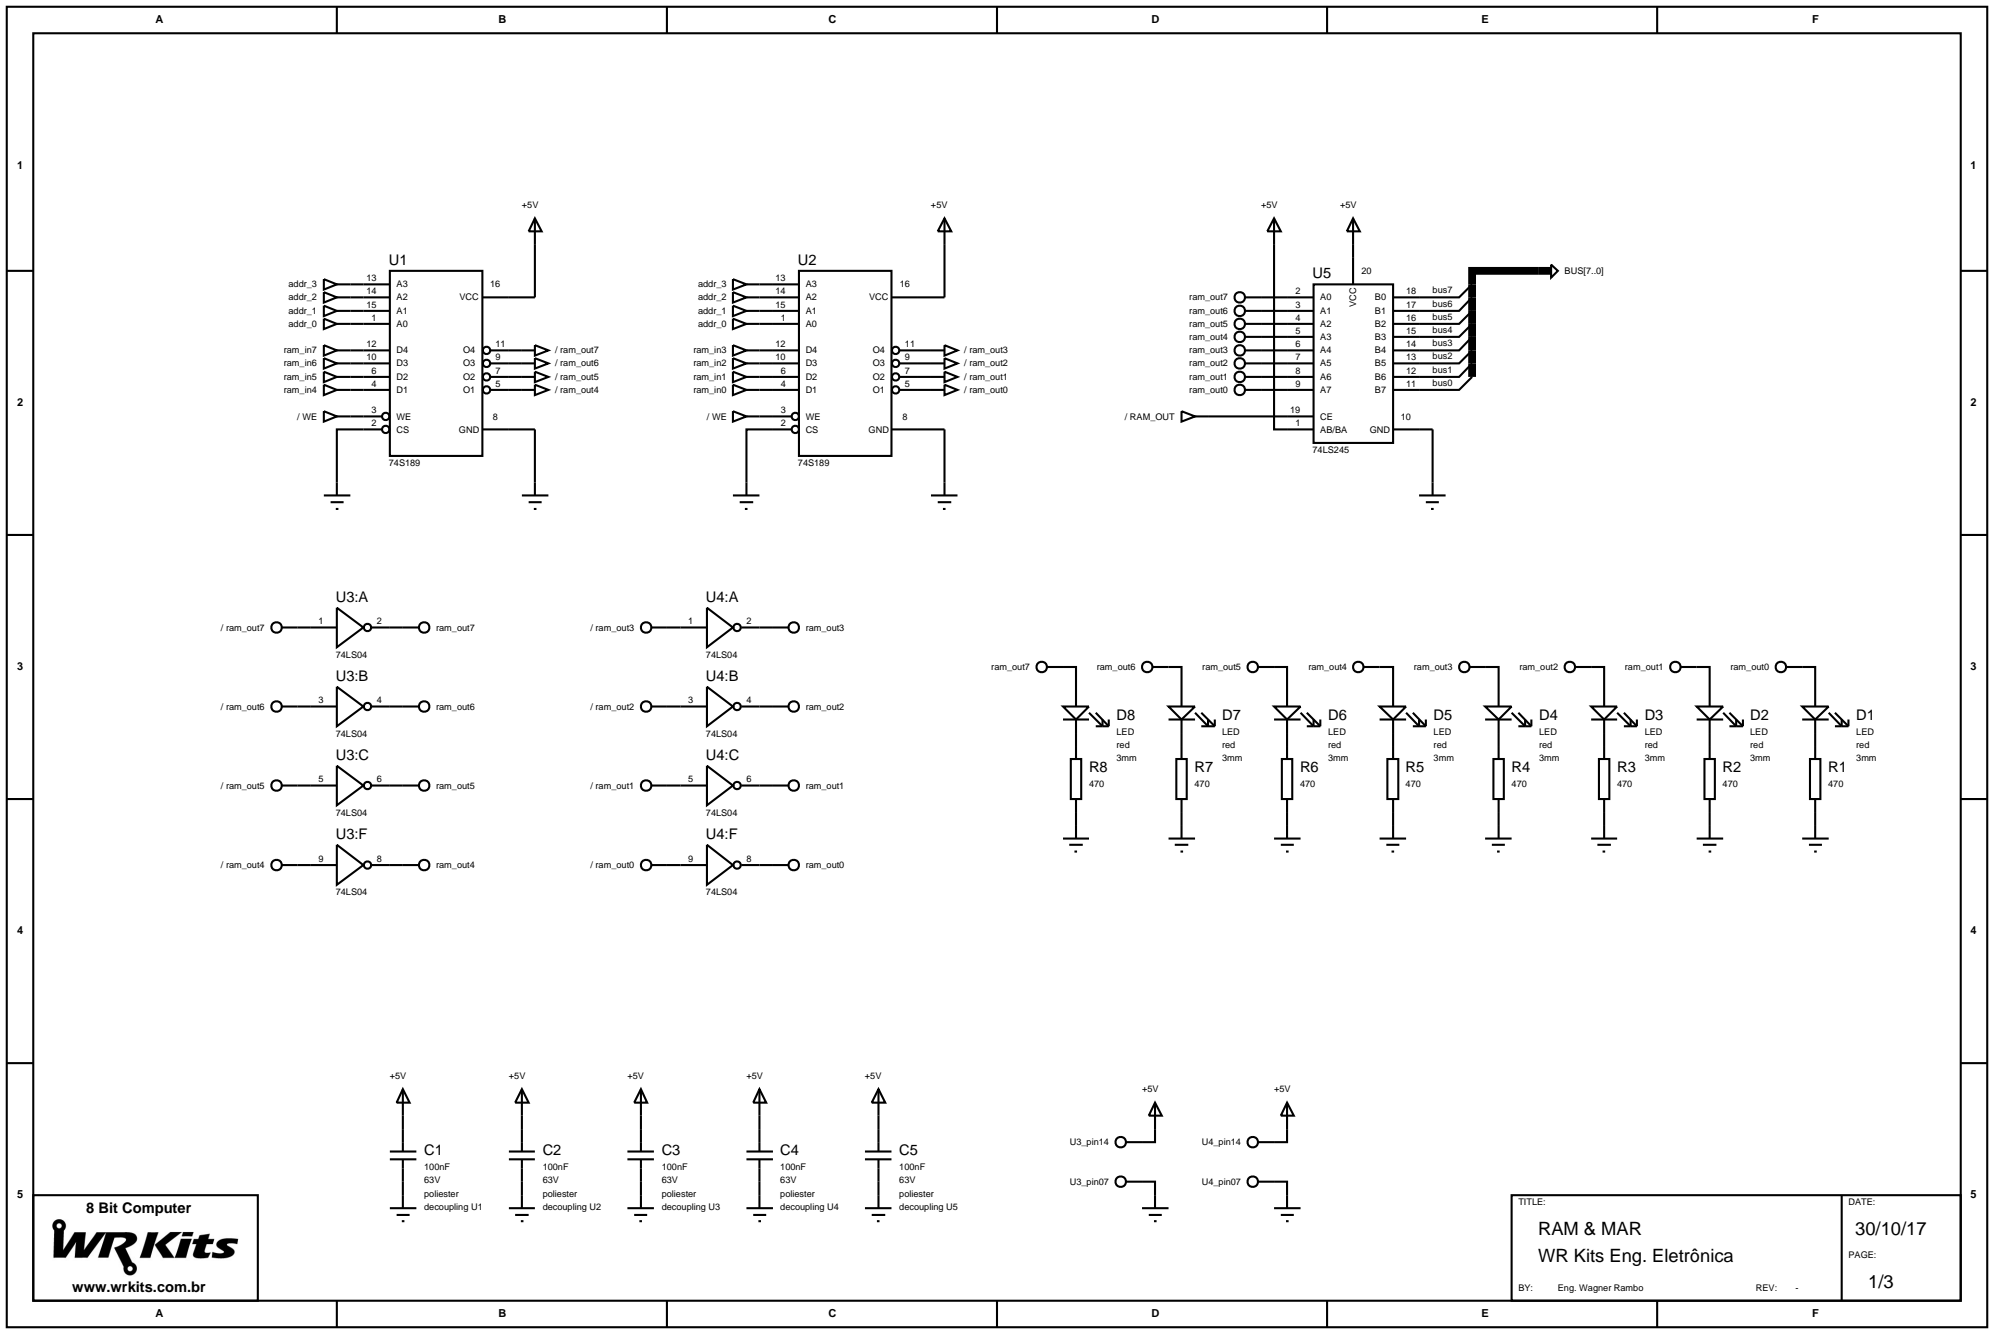
[picture p13: page 1]

TITLE:
RAM & MAR
WR Kits Eng. Eletrônica

www.wrkits.com.br

U6

# +5VVCC

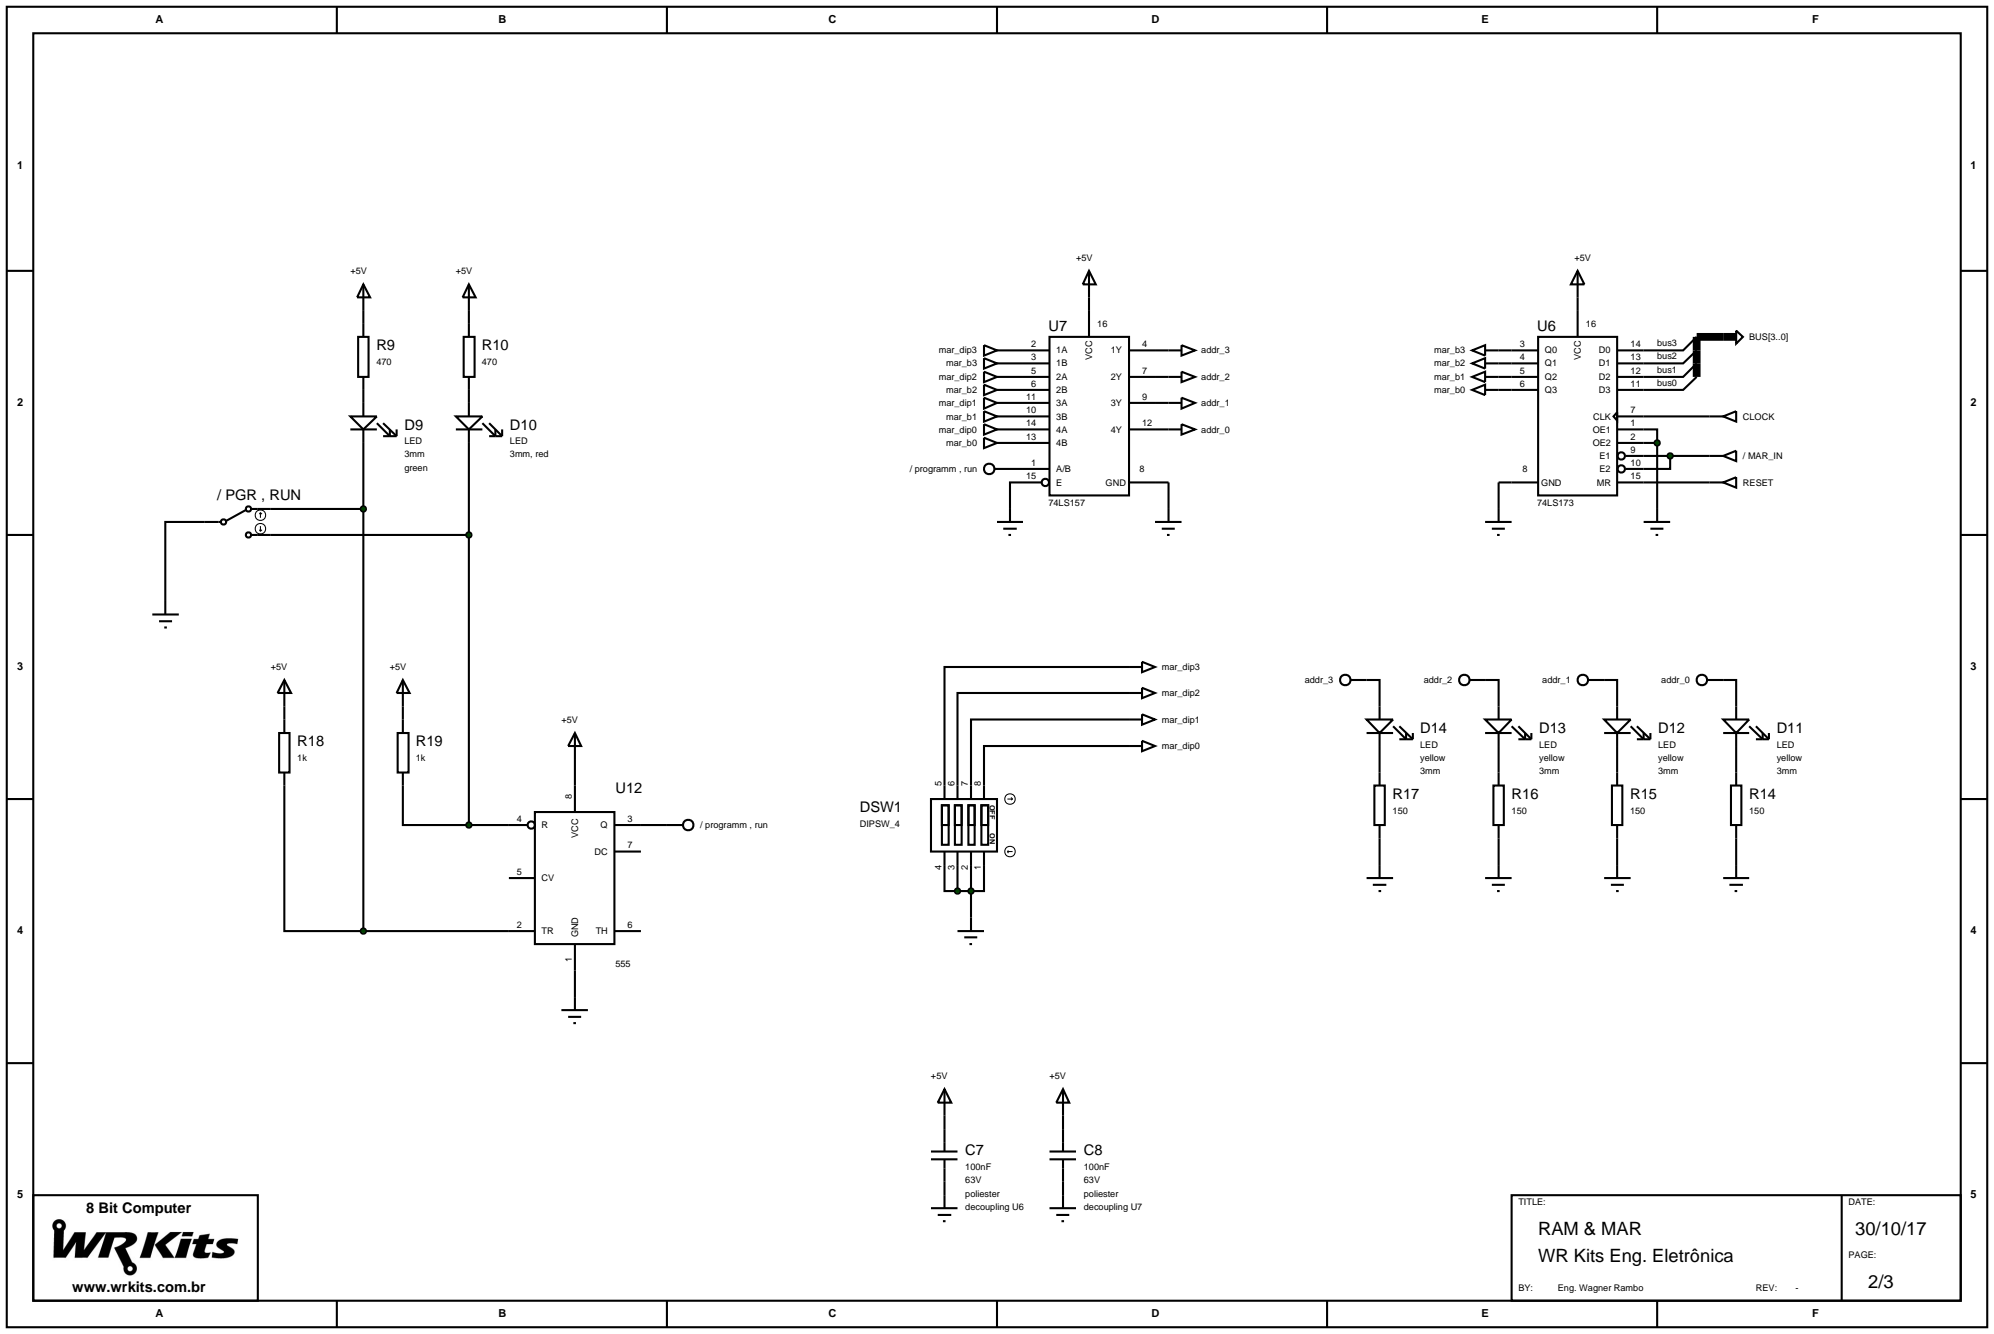
[picture p14: page 2]

U8

# +5VVCC 16

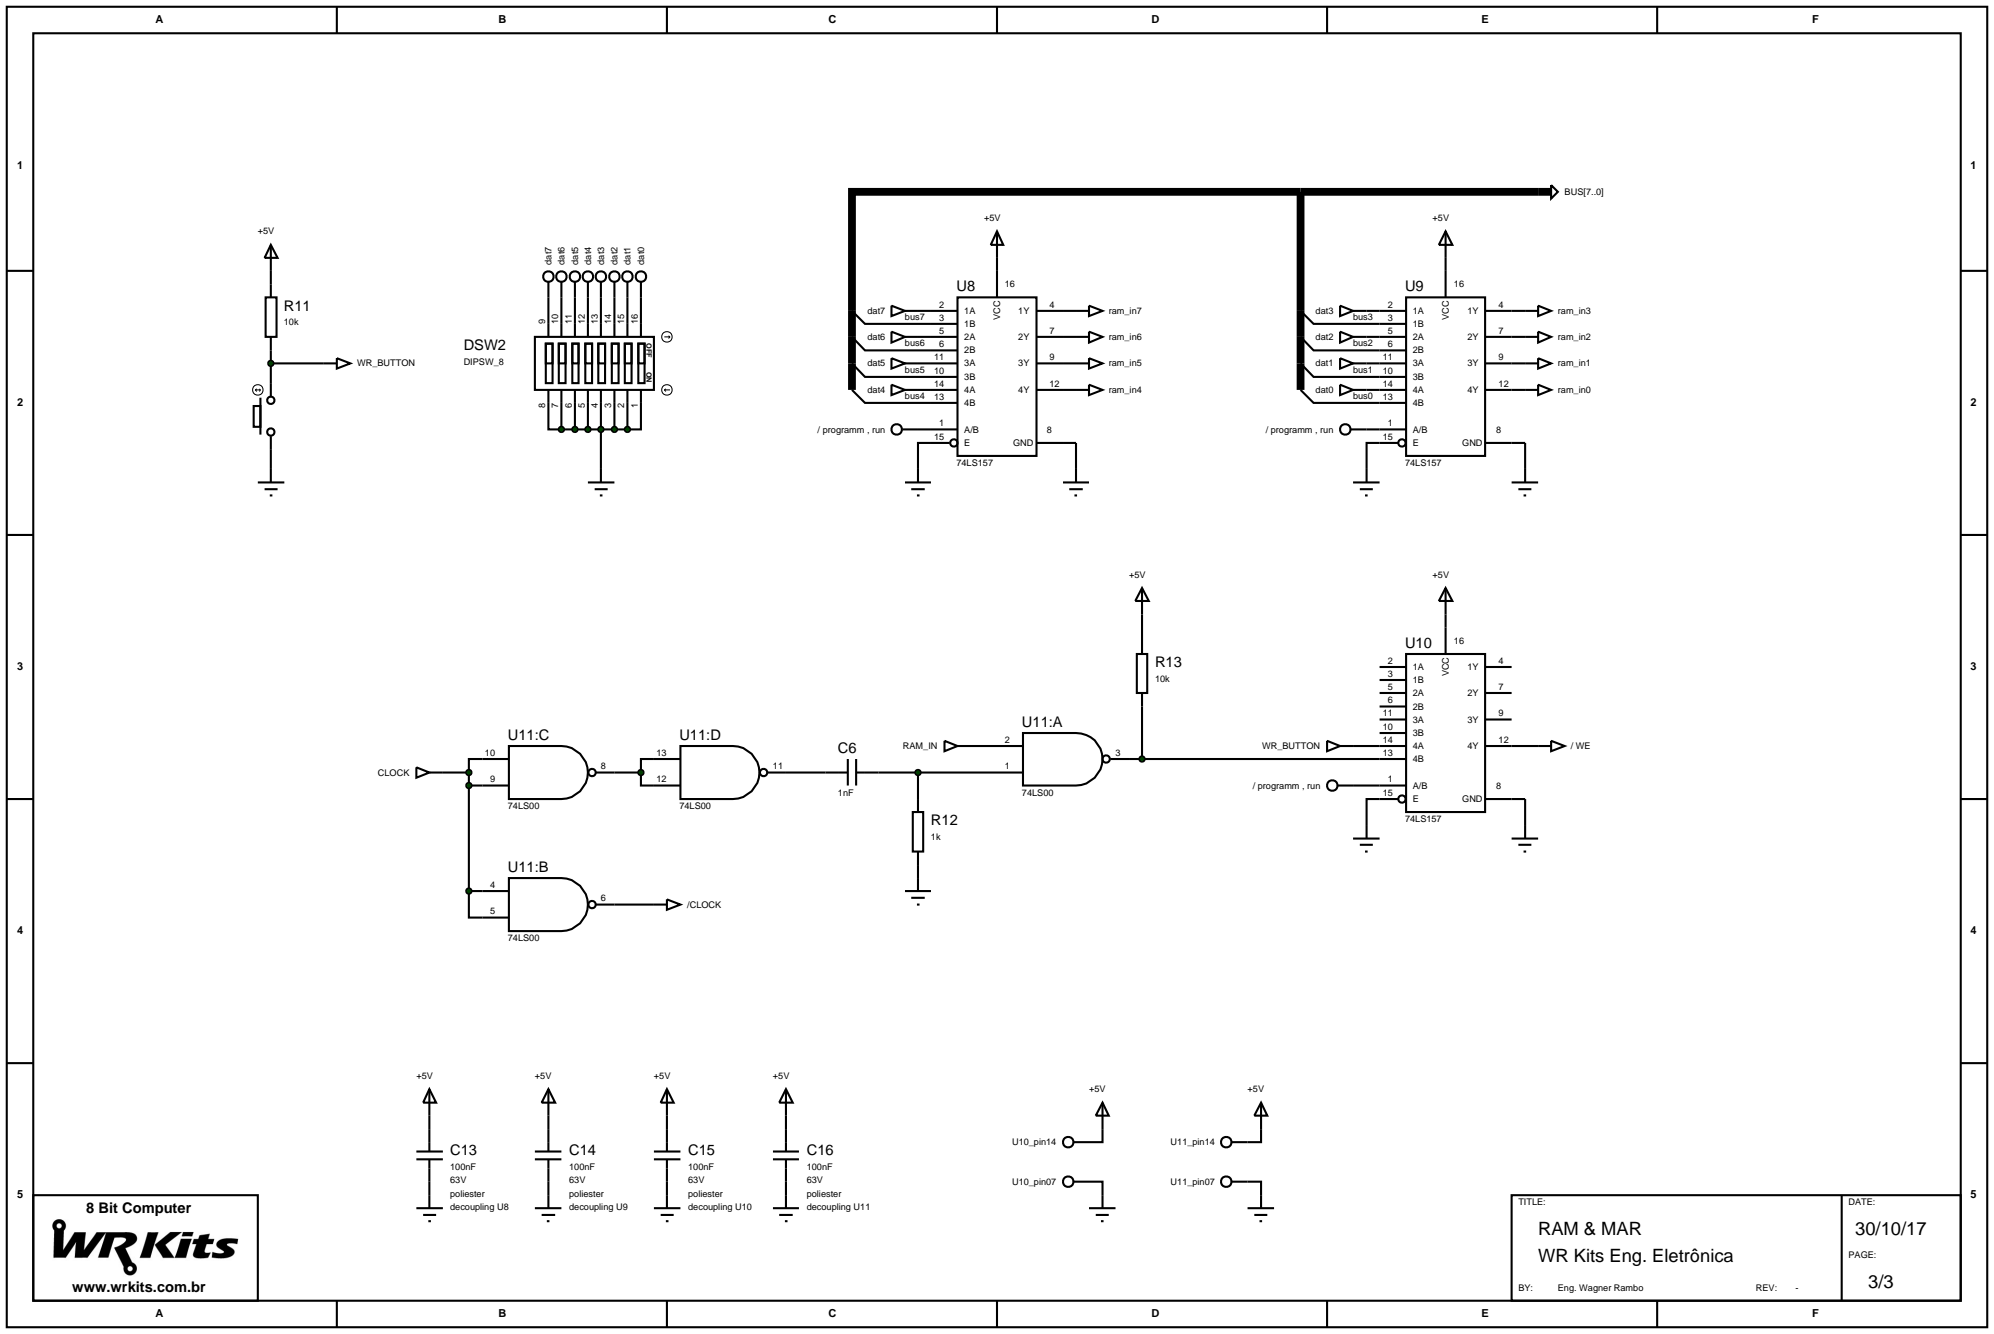
[picture p15: page 3]
