ZaqueuCavalcante/egbit/control_decoder_WR_8-bit_computer.PDF

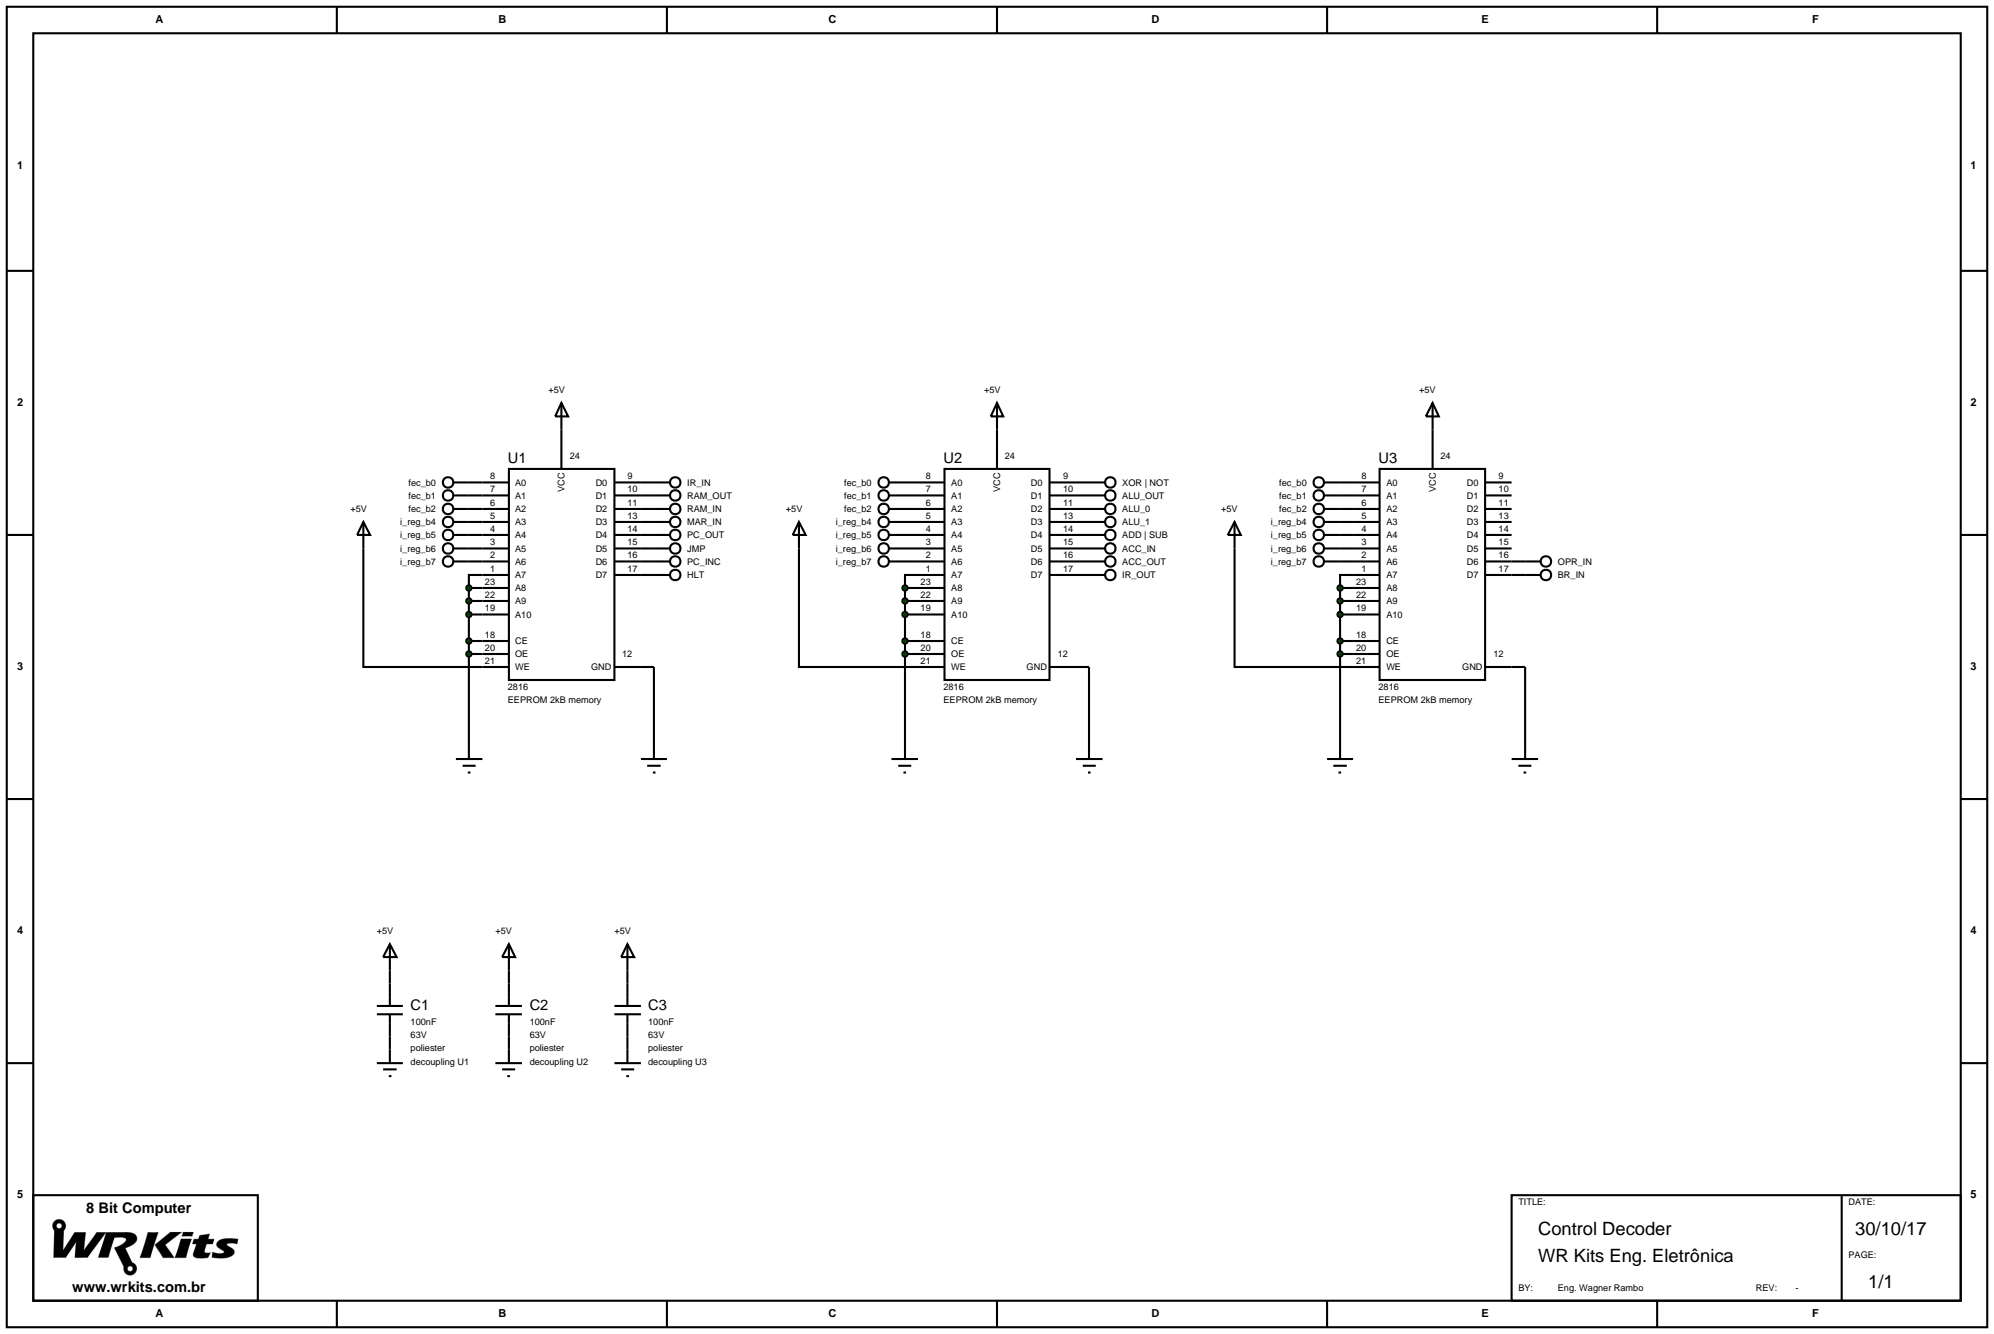
[picture p16: page 1]

TITLE:
Control Decoder
WR Kits Eng. Eletrônica

www.wrkits.com.br
