ZaqueuCavalcante/egbit/control_word_WR_8-bit_computer.PDF

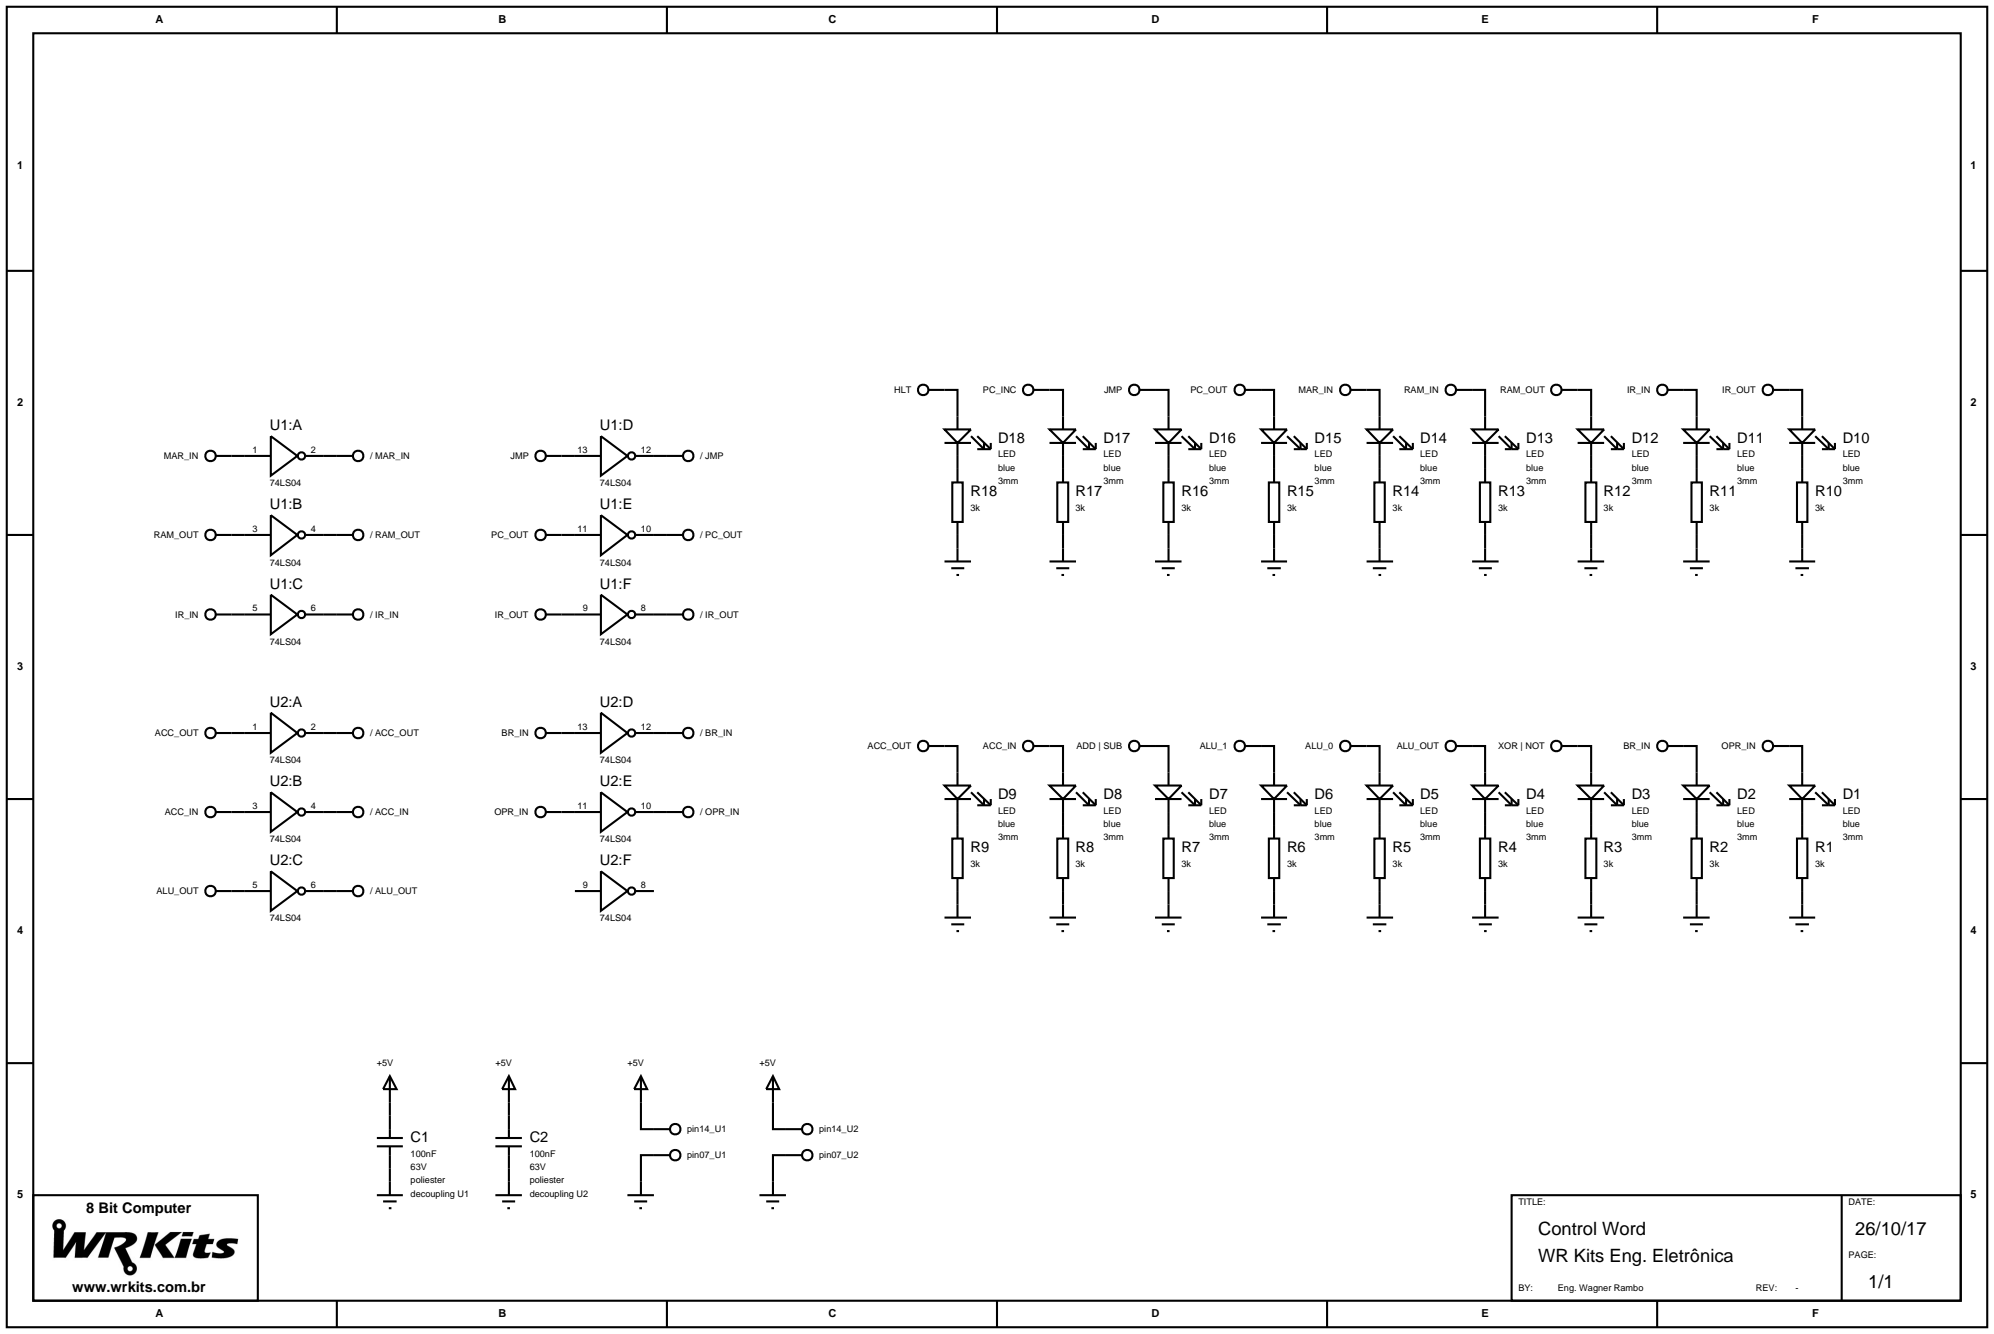
[picture p17: page 1]

TITLE:
Control Word
WR Kits Eng. Eletrônica

www.wrkits.com.br
