ZaqueuCavalcante/egbit/decimal_display_WR_8-bit_computer.PDF

## DISPLAY

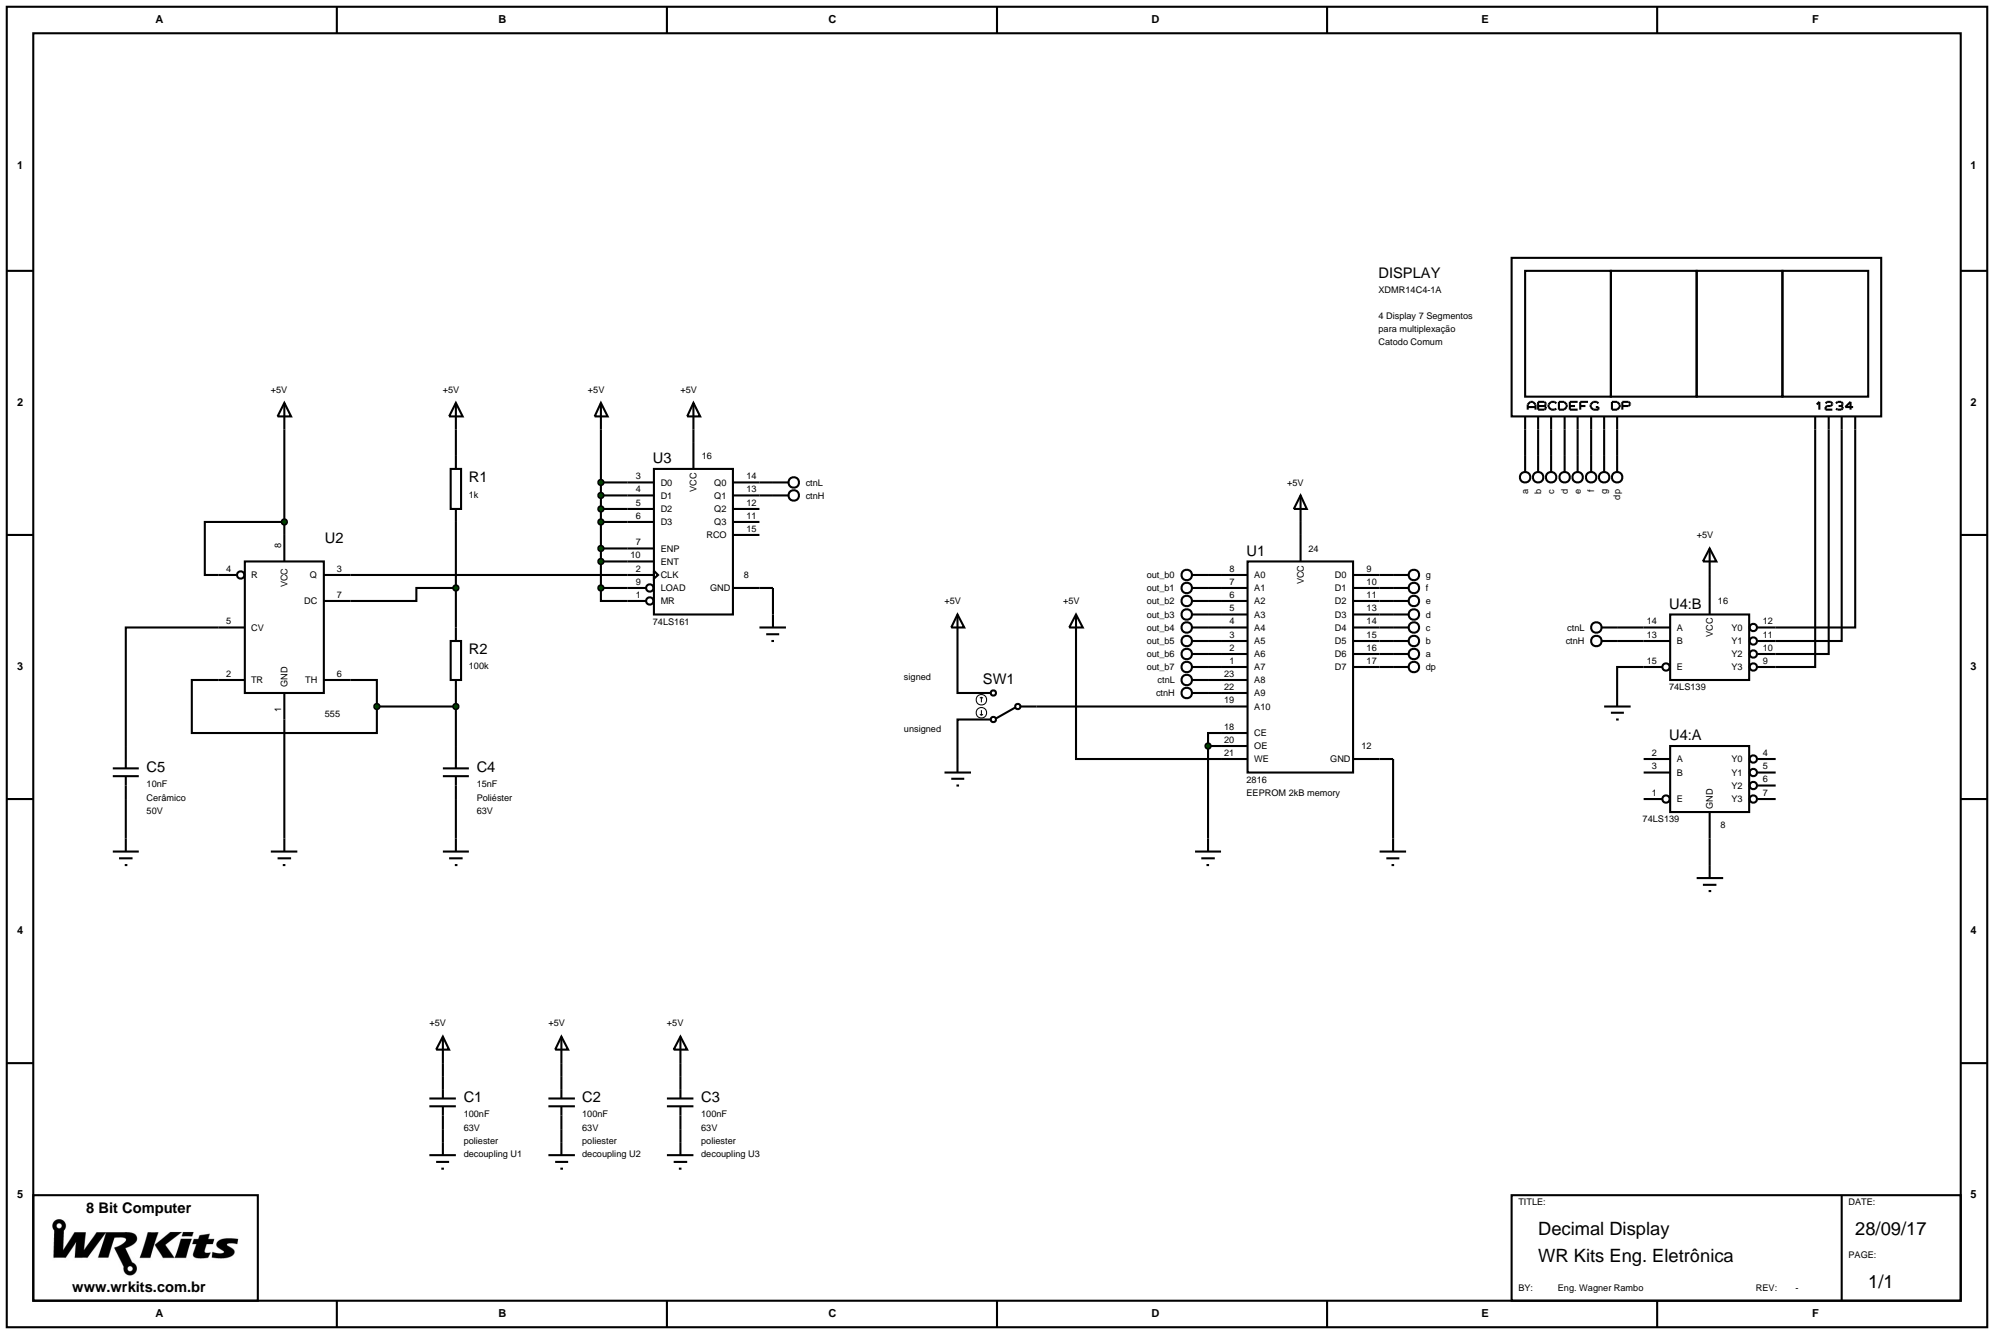
[picture p18: page 1]

TITLE:
Decimal Display
WR Kits Eng. Eletrônica

www.wrkits.com.br
