ZaqueuCavalcante/egbit/fetch_execution_counter_WR_8-bit_computer.PDF

# +5VVCC 16

# +5VVCC 16

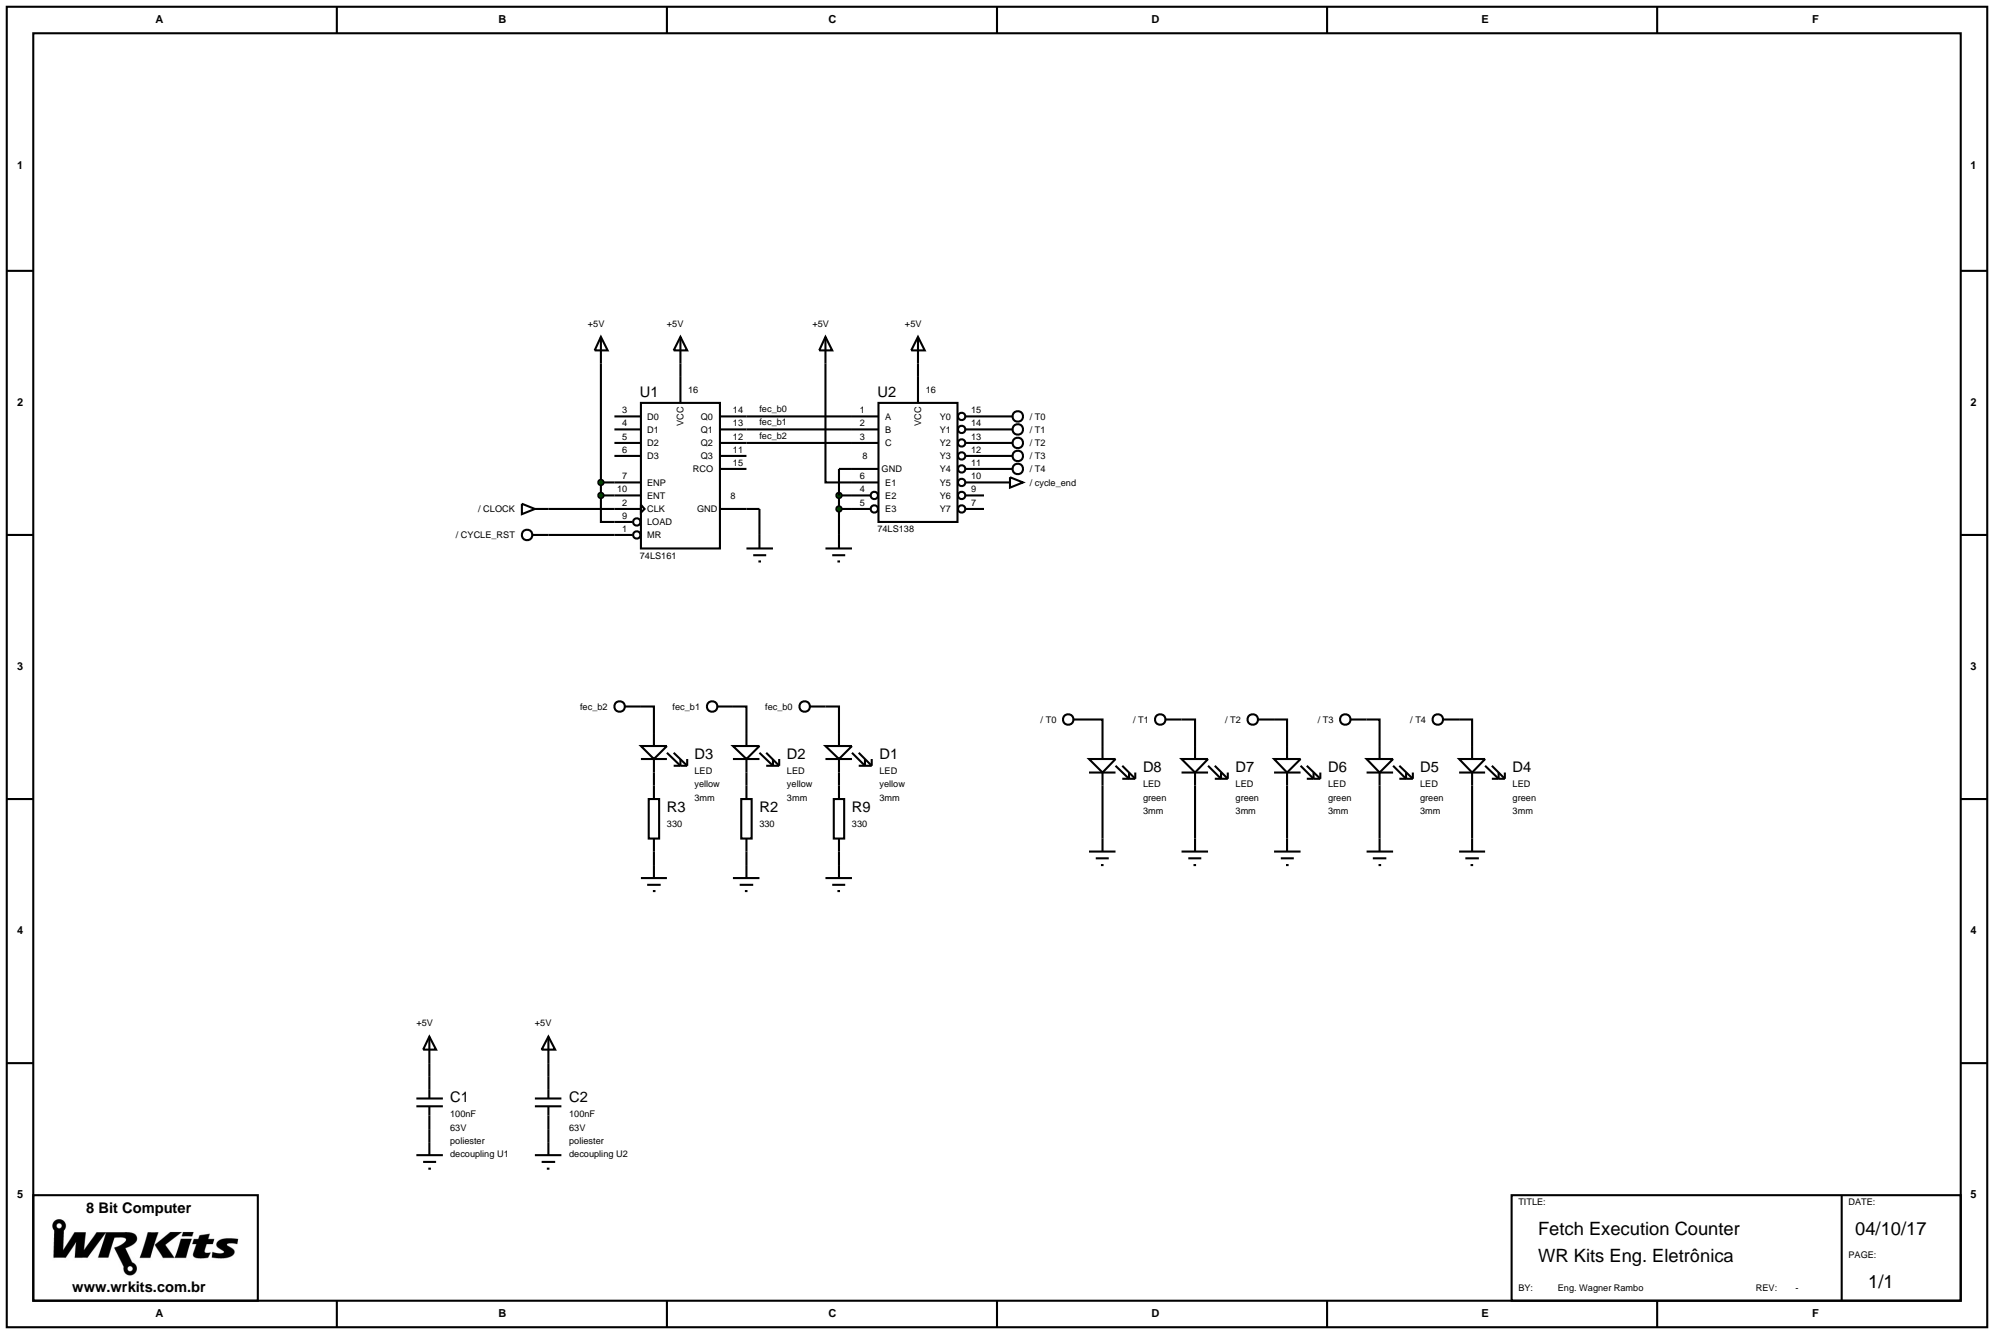
[picture p19: page 1]

TITLE:
Fetch Execution Counter
WR Kits Eng. Eletrônica

www.wrkits.com.br
