ZaqueuCavalcante/egbit/output_register_WR_8-bit_computer.PDF

U1

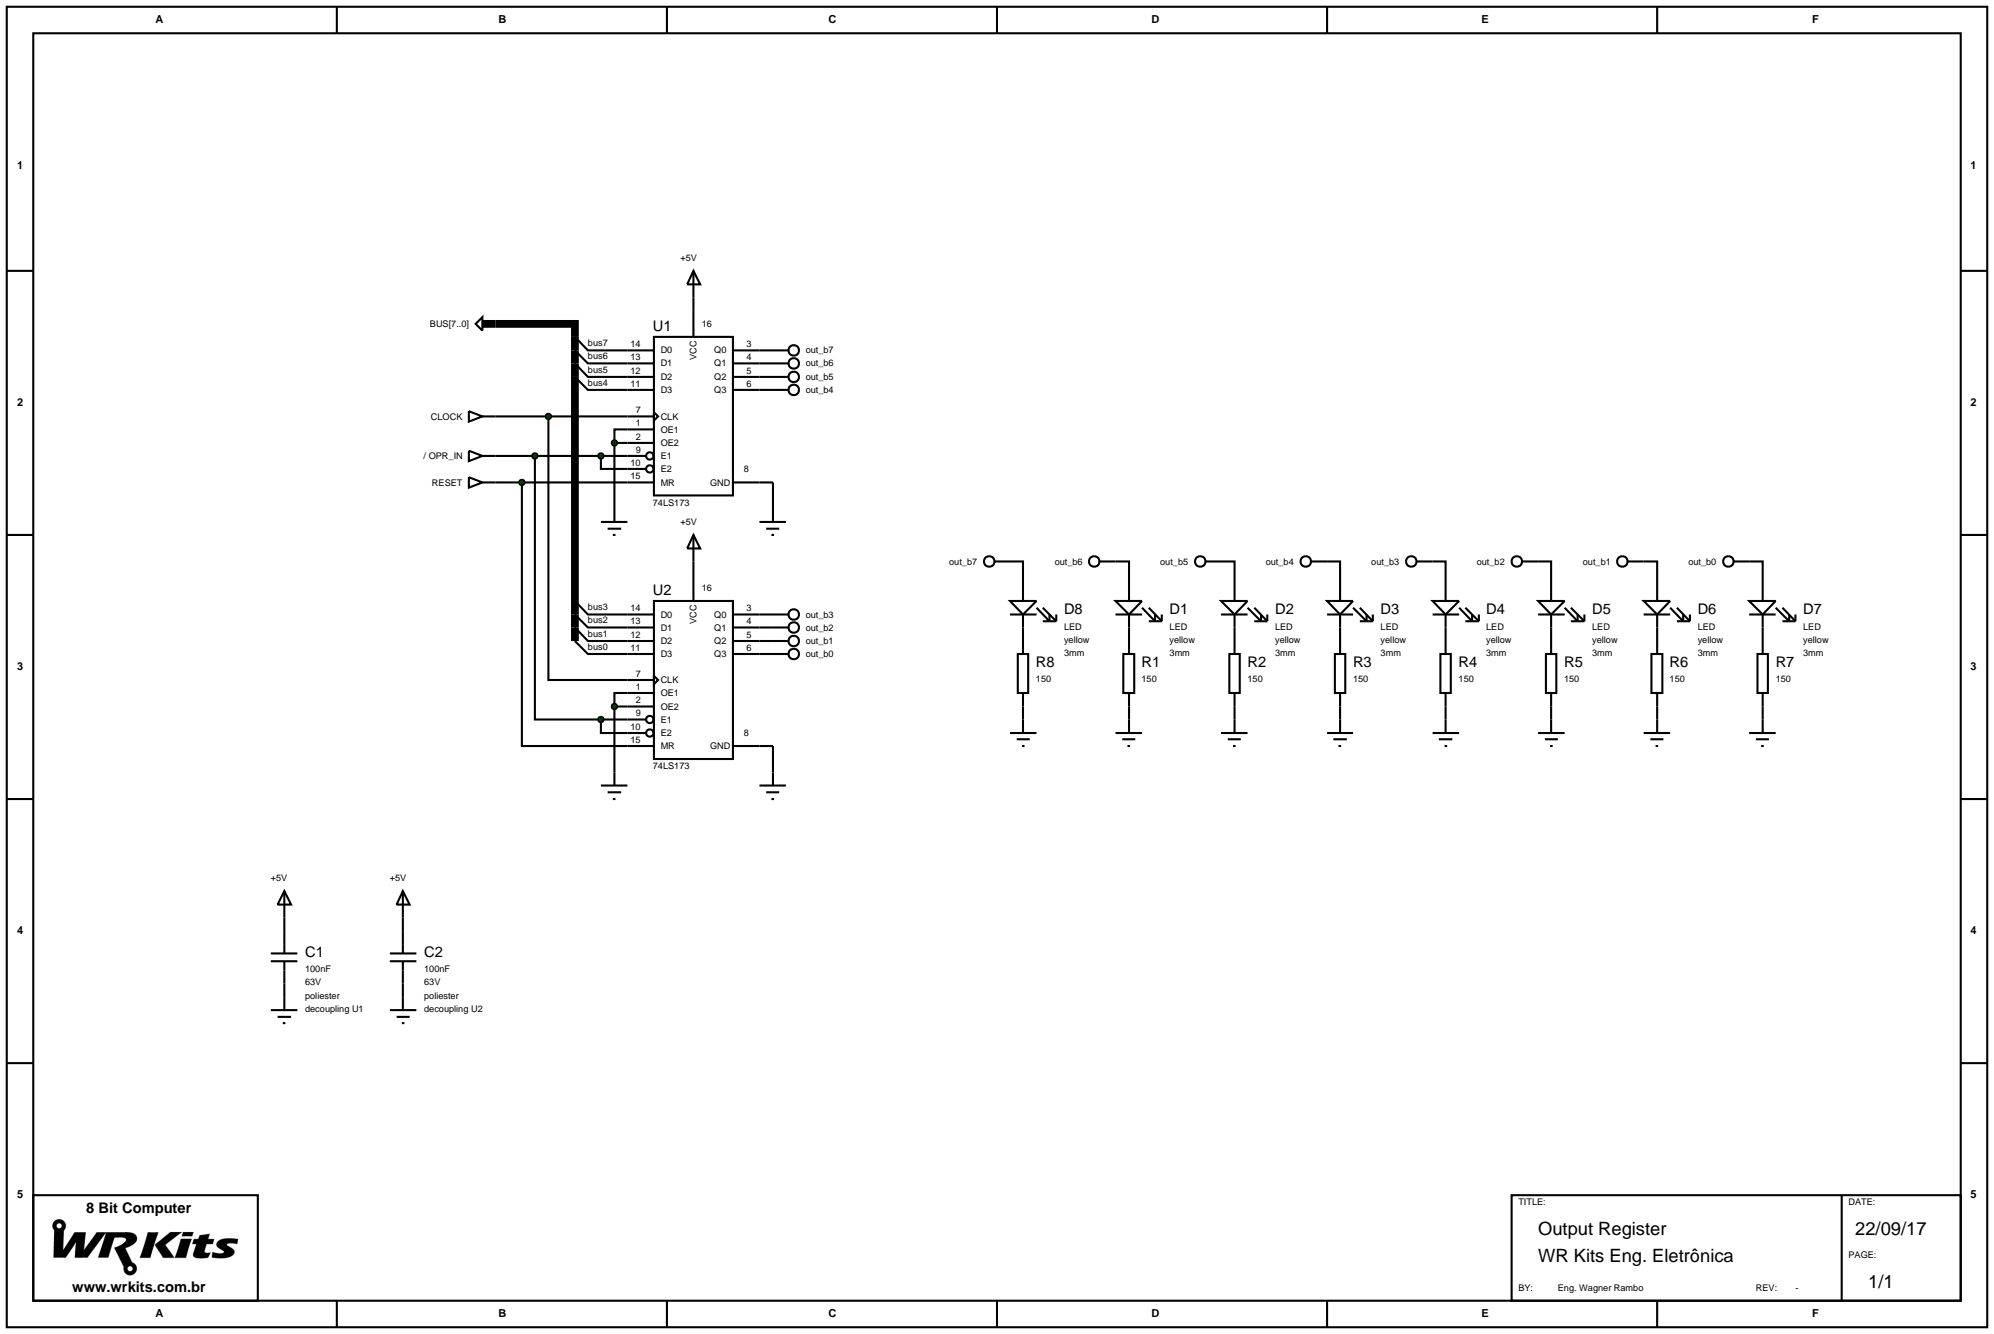
[picture p20: page 1]

TITLE:
Output Register
WR Kits Eng. Eletrônica

www.wrkits.com.br
