ZaqueuCavalcante/egbit/wr/8-bit_computer_08_WR_files/alu_WR_8-bit_computer.PDF

U1

U2

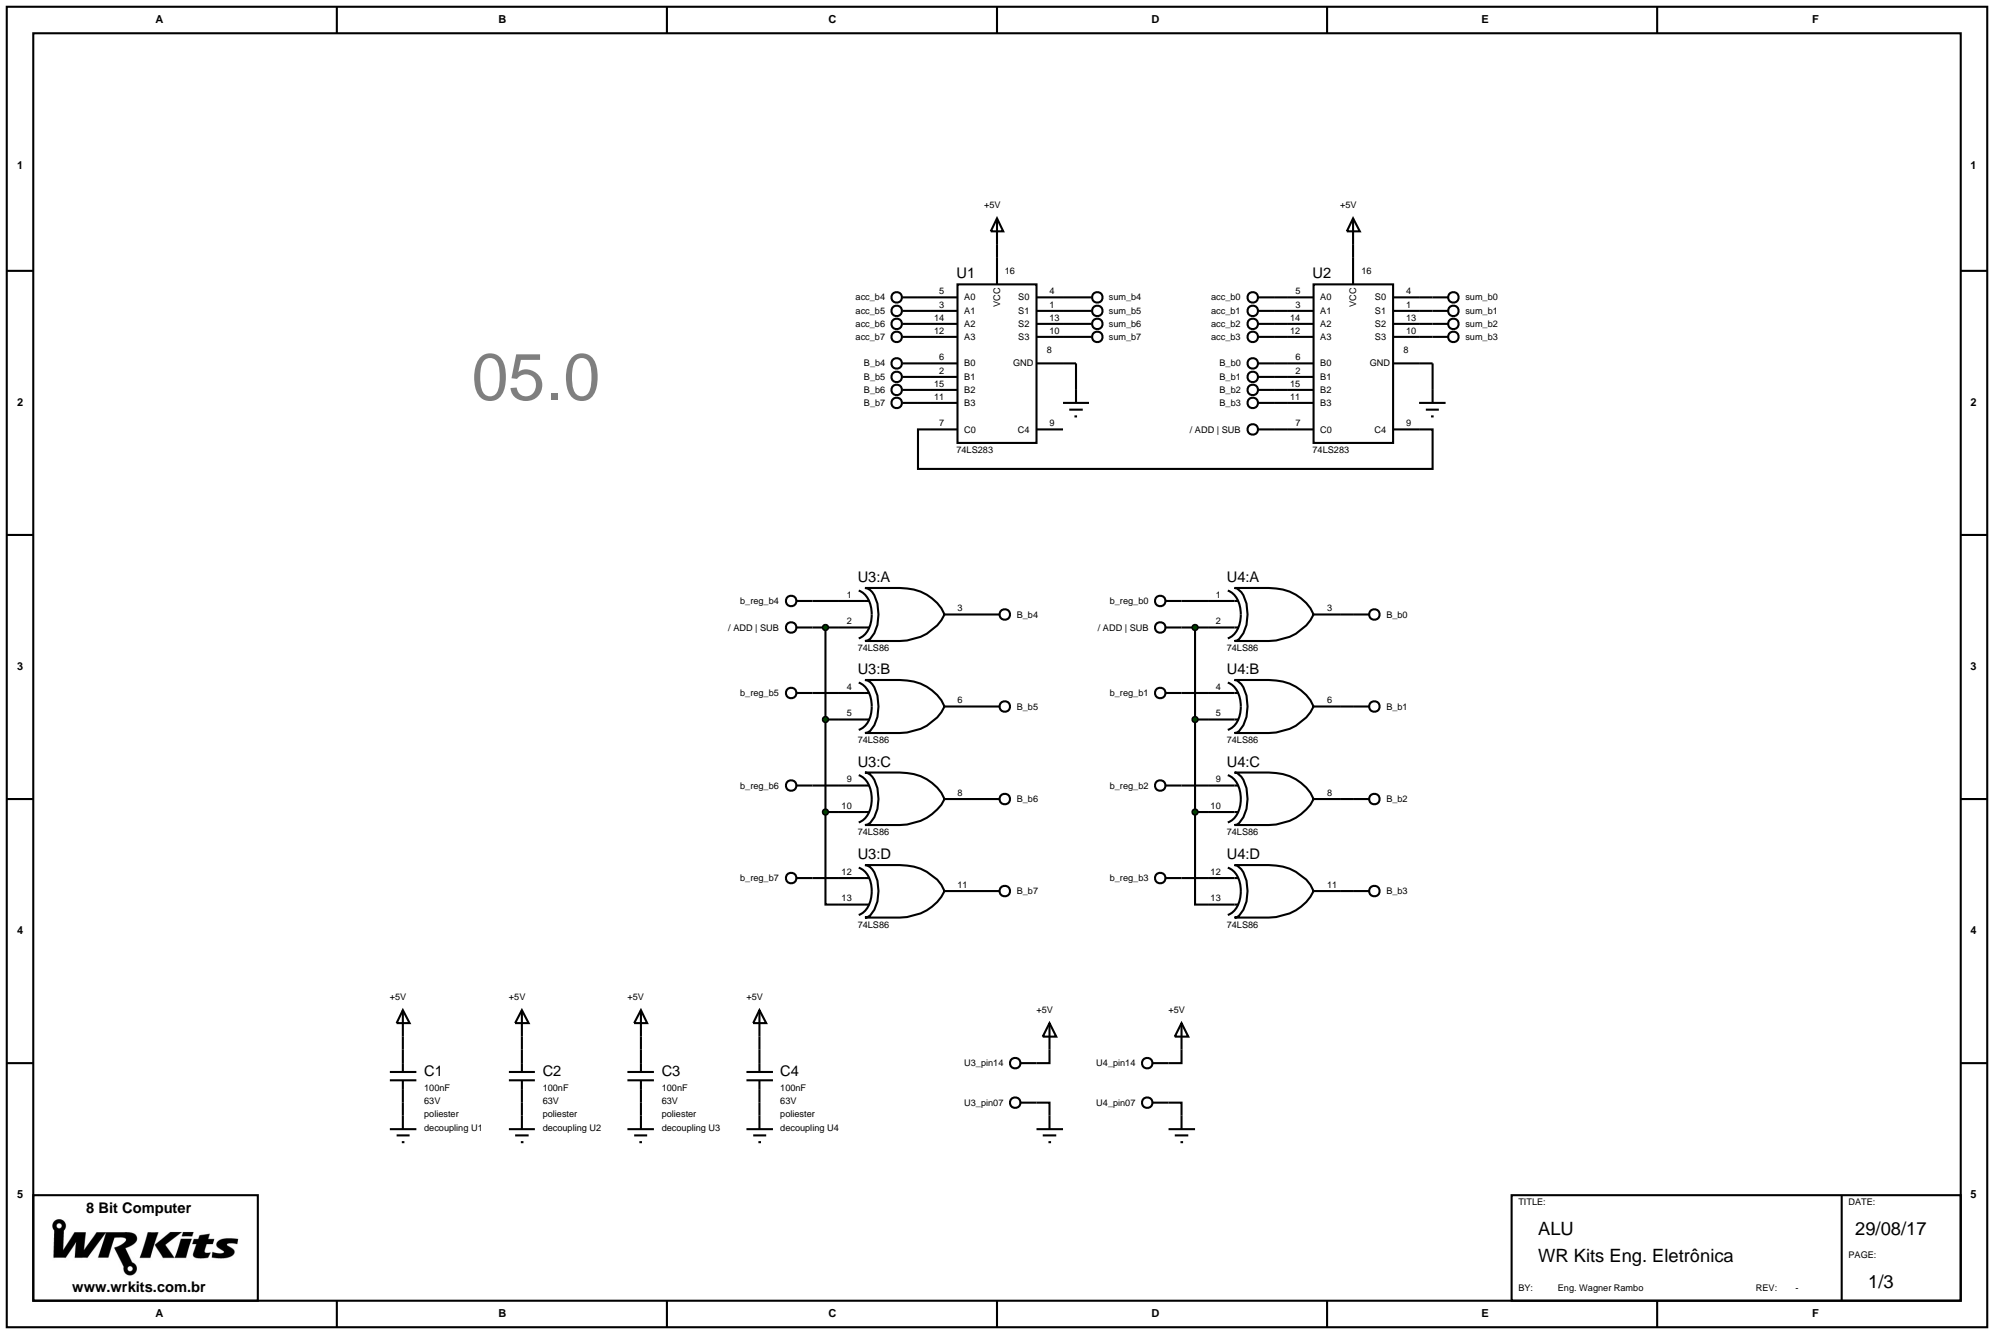
[picture p21: page 1]

TITLE:
ALU
WR Kits Eng. Eletrônica

www.wrkits.com.br

U5:A

U5:B

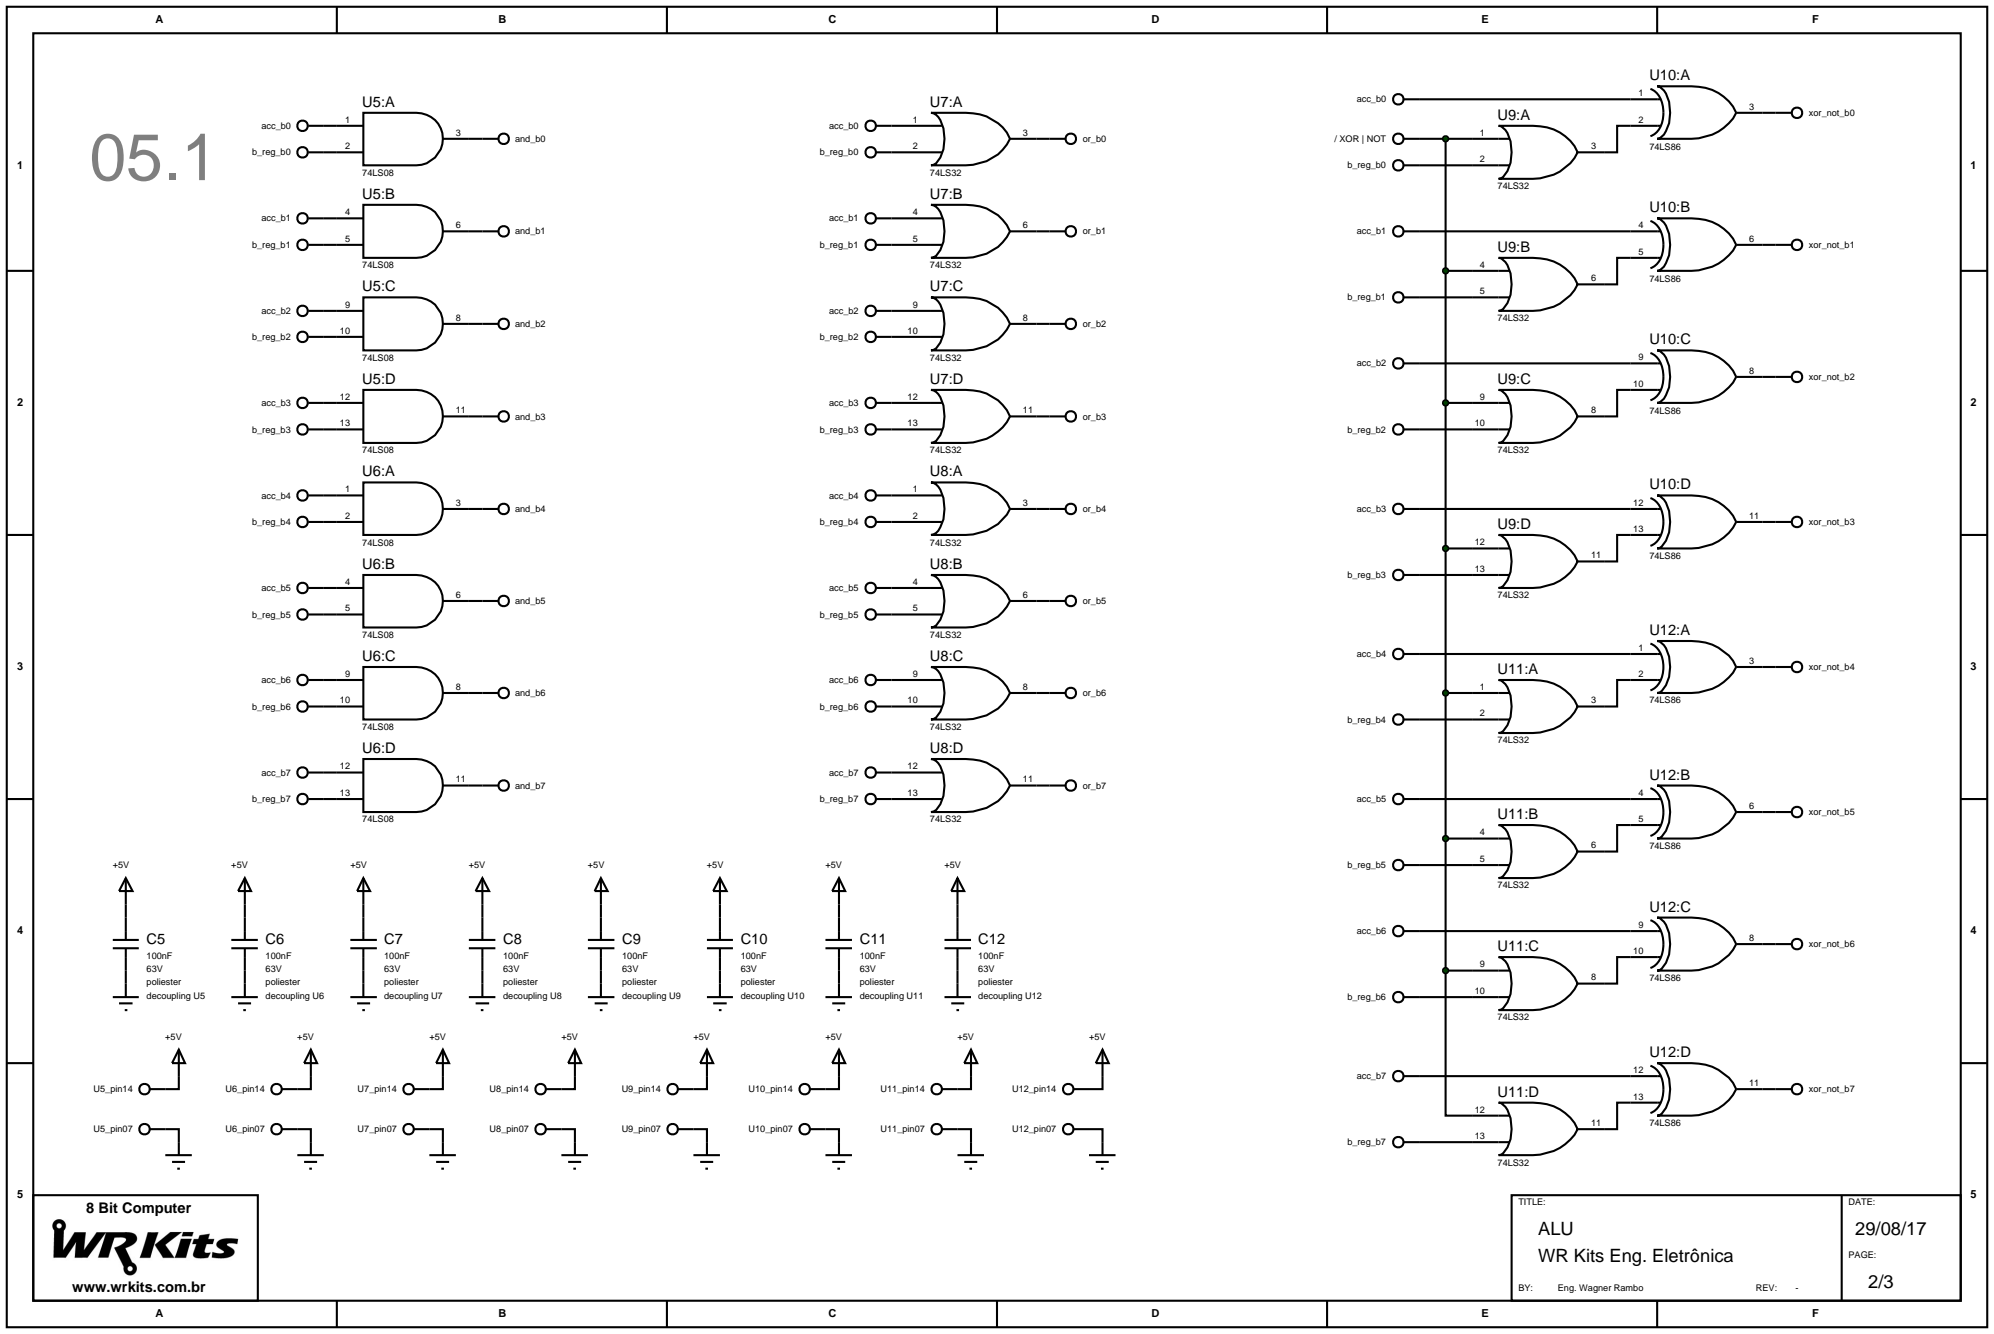
[picture p22: page 2]

U13

U15

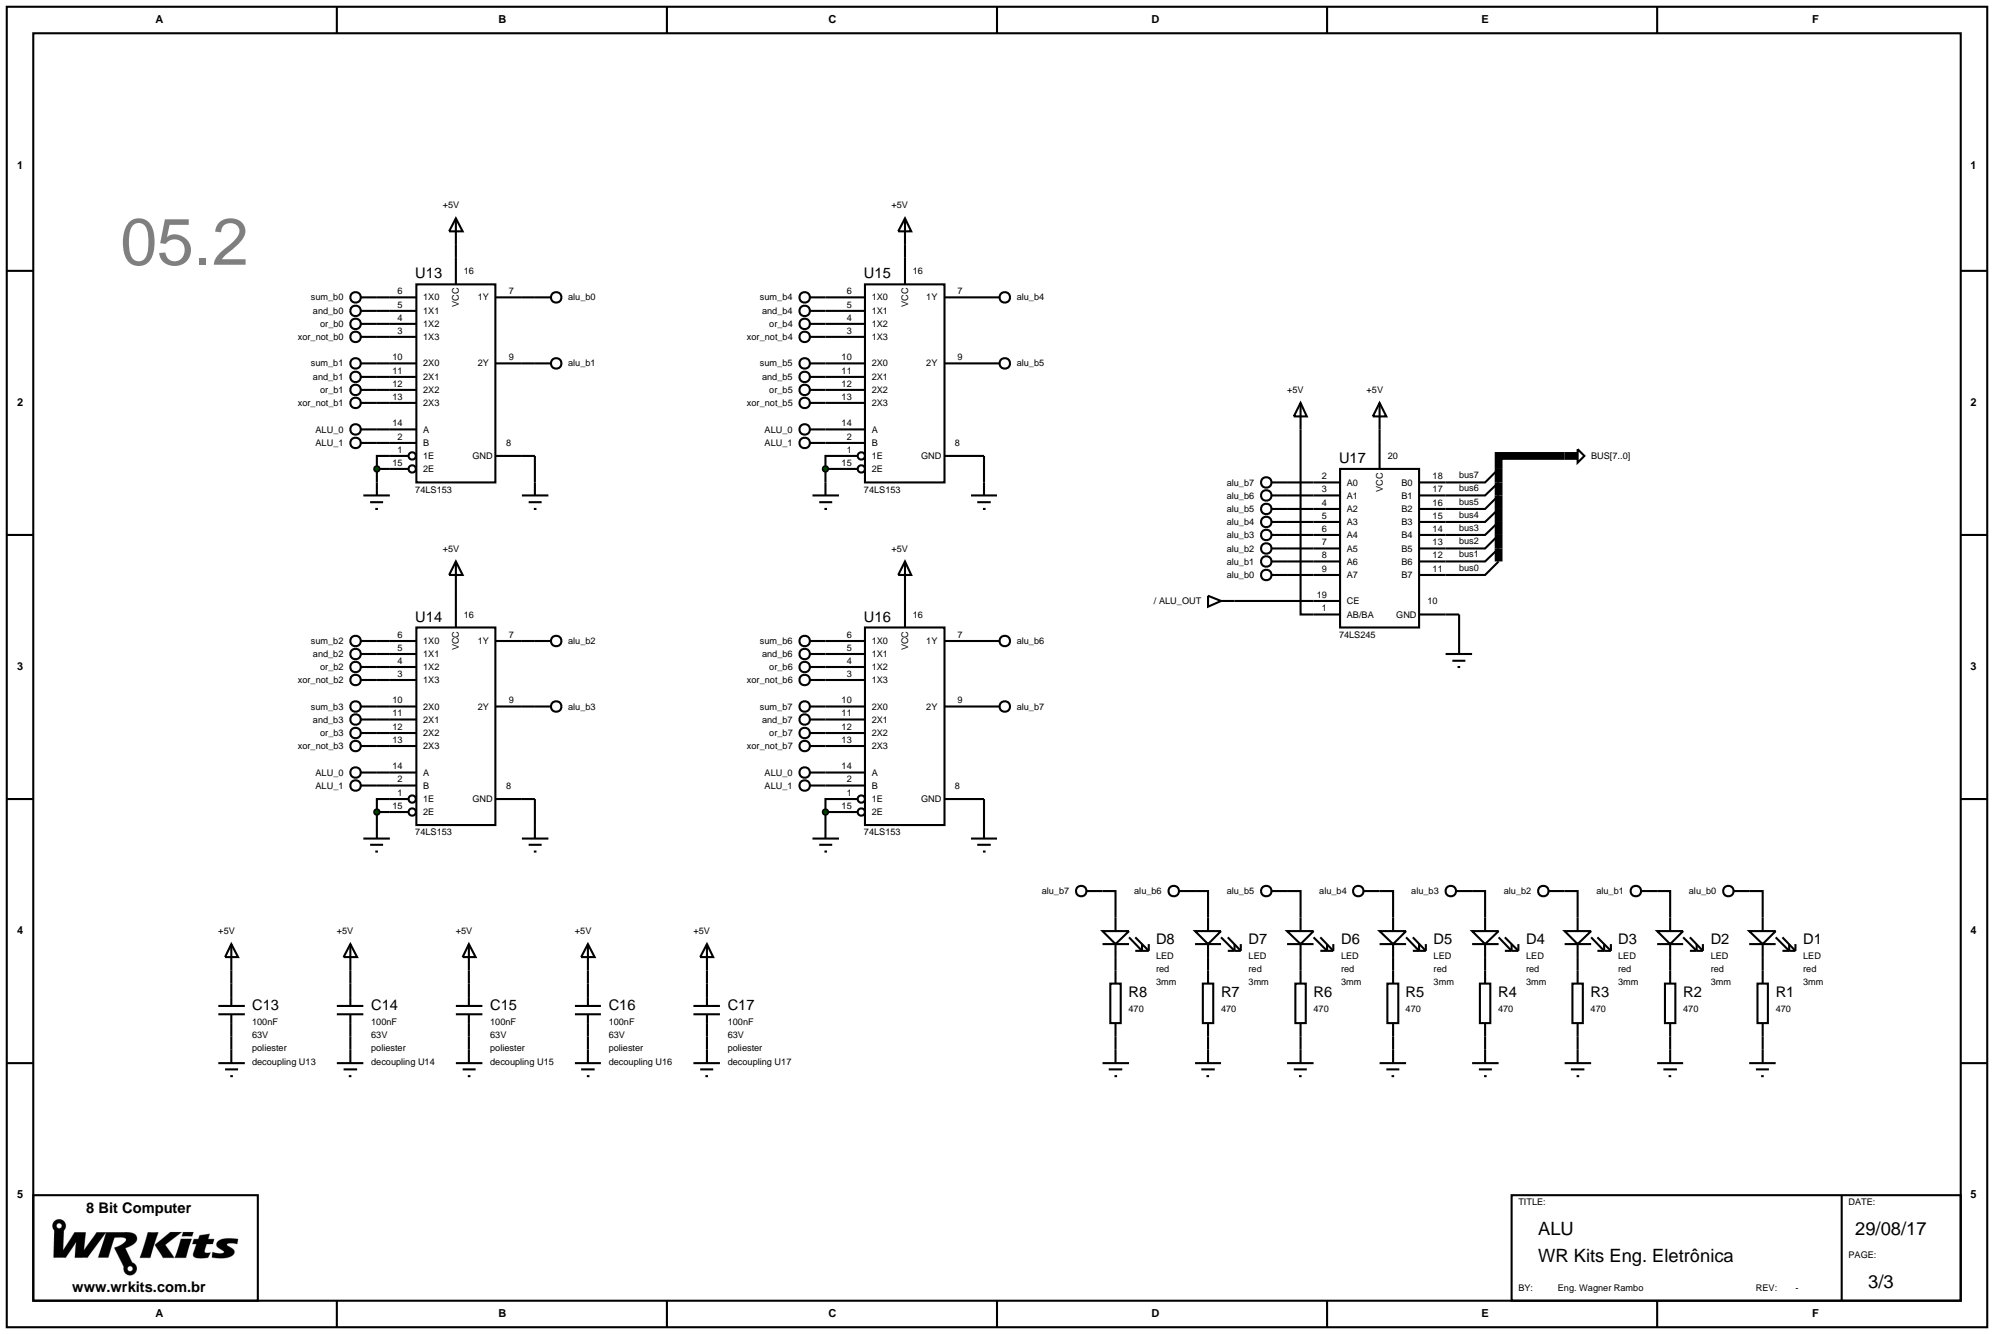
[picture p23: page 3]
