ZaqueuCavalcante/egbit/wr/8-bit_computer_00_WR_files/arquitetura_8-bit_computer.PDF

## ACCUMULATOR A REGISTER

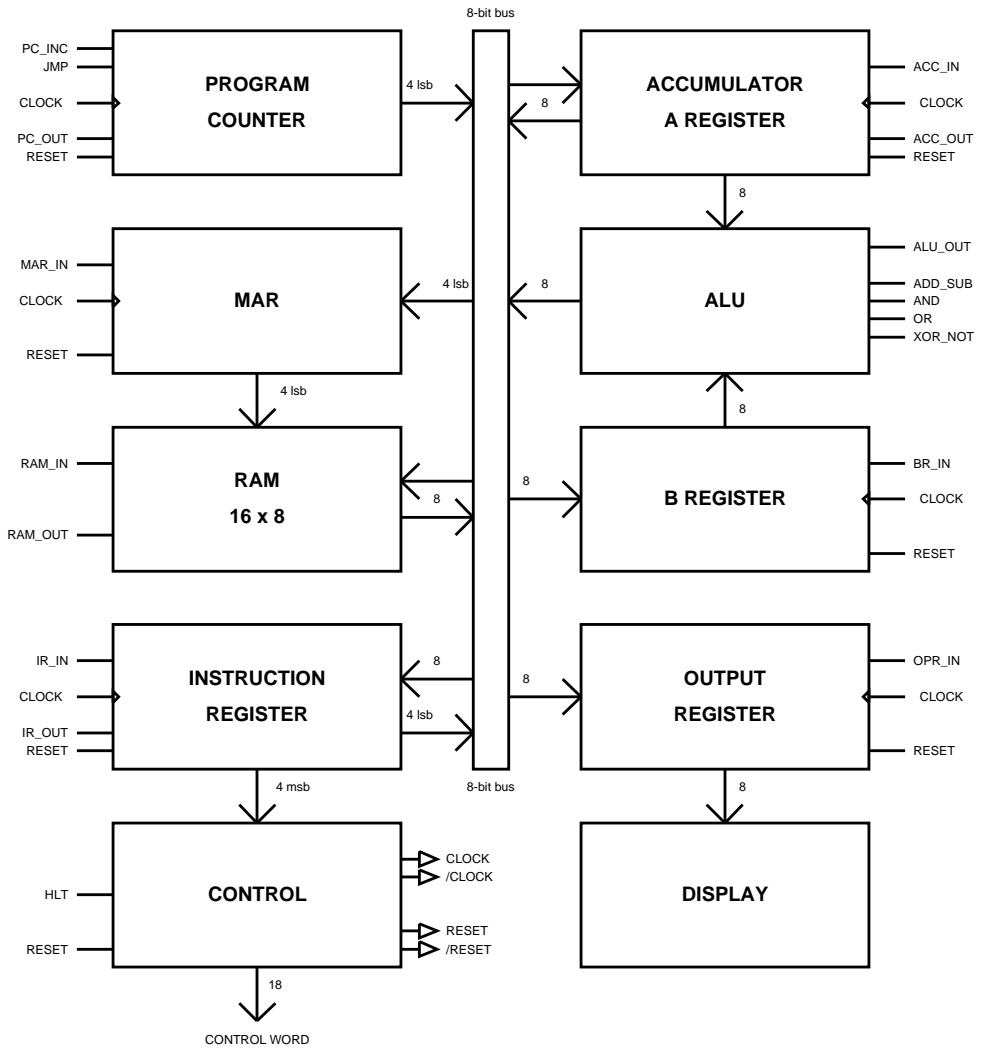
[picture p24: page 1]
DATE:; PAGE:; Eng. Wagner Rambo; REV:; 8 Bit Computer; ALU_OUT; ADD_SUB AND OR XOR_NOT; ALU; ACC_IN; ACC_OUT; CLOCK; B REGISTER; PC_INC; PC_OUT; PROGRAM; COUNTER; JMP; MAR; MAR_IN; RAM; RAM_IN; INSTRUCTION; REGISTER; IR_OUT; OPR_IN; OUTPUT; CONTROL; DISPLAY; CLOCK /CLOCK; RESET /RESET; 8-bit bus; RESET; 4 lsb; 4 msb; CONTROL WORD; HLT; RAM_OUT

TITLE:
Arquitetura
WR Kits Eng. Eletrônica

www.wrkits.com.br
