ZaqueuCavalcante/egbit/wr/8-bit_computer_04_WR_files/arquitetura_8-bit_computer_big.PDF

# PROGRAM COUNTER CLOCK

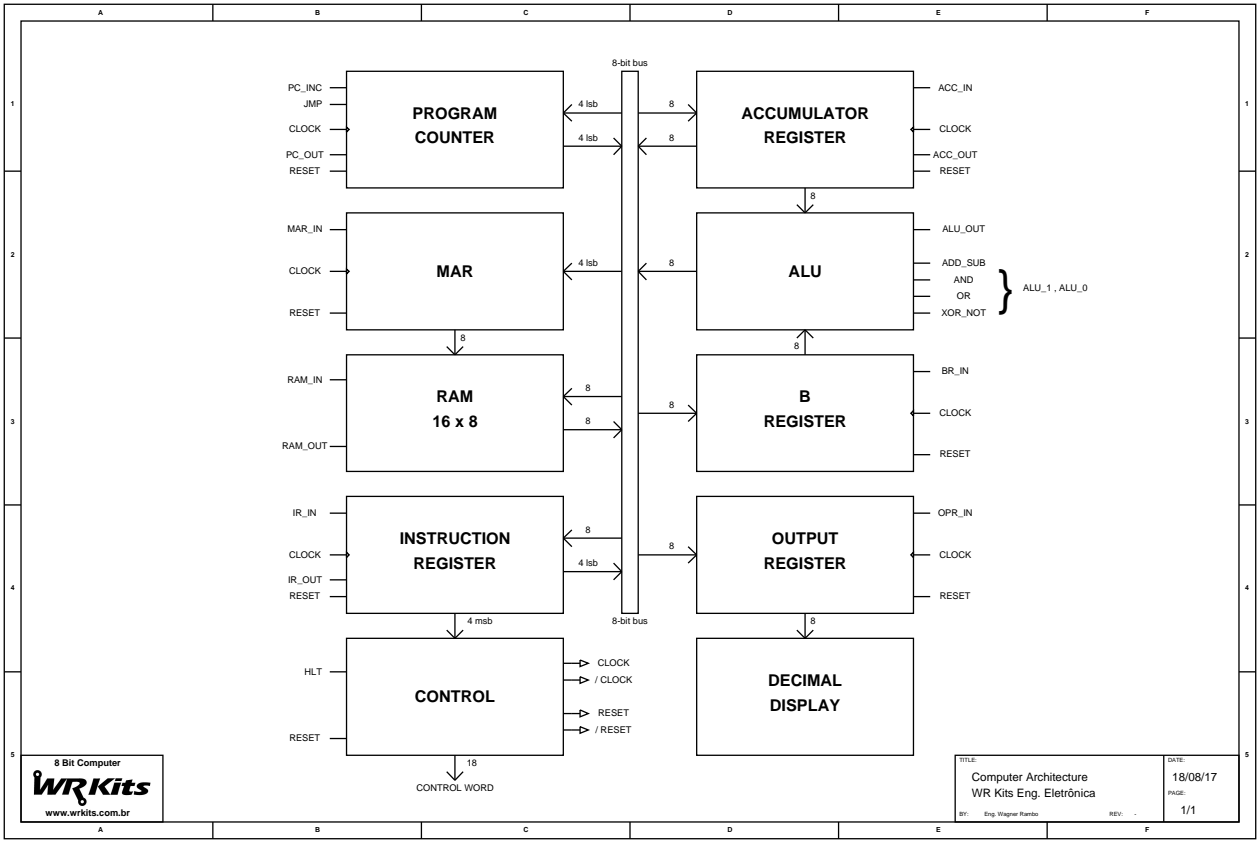
[picture p25: page 1]
DATE:; PAGE:; Eng. Wagner Rambo; REV:; 8 Bit Computer; 8-bit bus; 4 lsb; JMP; PC_INC; PC_OUT RESET; CLOCK; MAR; MAR_IN; RESET; RAM 16 x 8; RAM_IN; RAM_OUT; INSTRUCTION REGISTER CLOCK; IR_OUT; CONTROL; HLT; 4 msb; CONTROL WORD; / CLOCK; / RESET; ACCUMULATOR; REGISTER; ACC_IN; ACC_OUT RESET; ALU; ALU_OUT; ADD_SUB; B REGISTER; OUTPUT; OPR_IN; DECIMAL DISPLAY; XOR_NOT; AND; ALU_1 , ALU_0

TITLE:
Computer Architecture
WR Kits Eng. Eletrônica

www.wrkits.com.br
