ZaqueuCavalcante/egbit/wr/8-bit_computer_09_WR_files/RAM_MAR.PDF

U1

U2

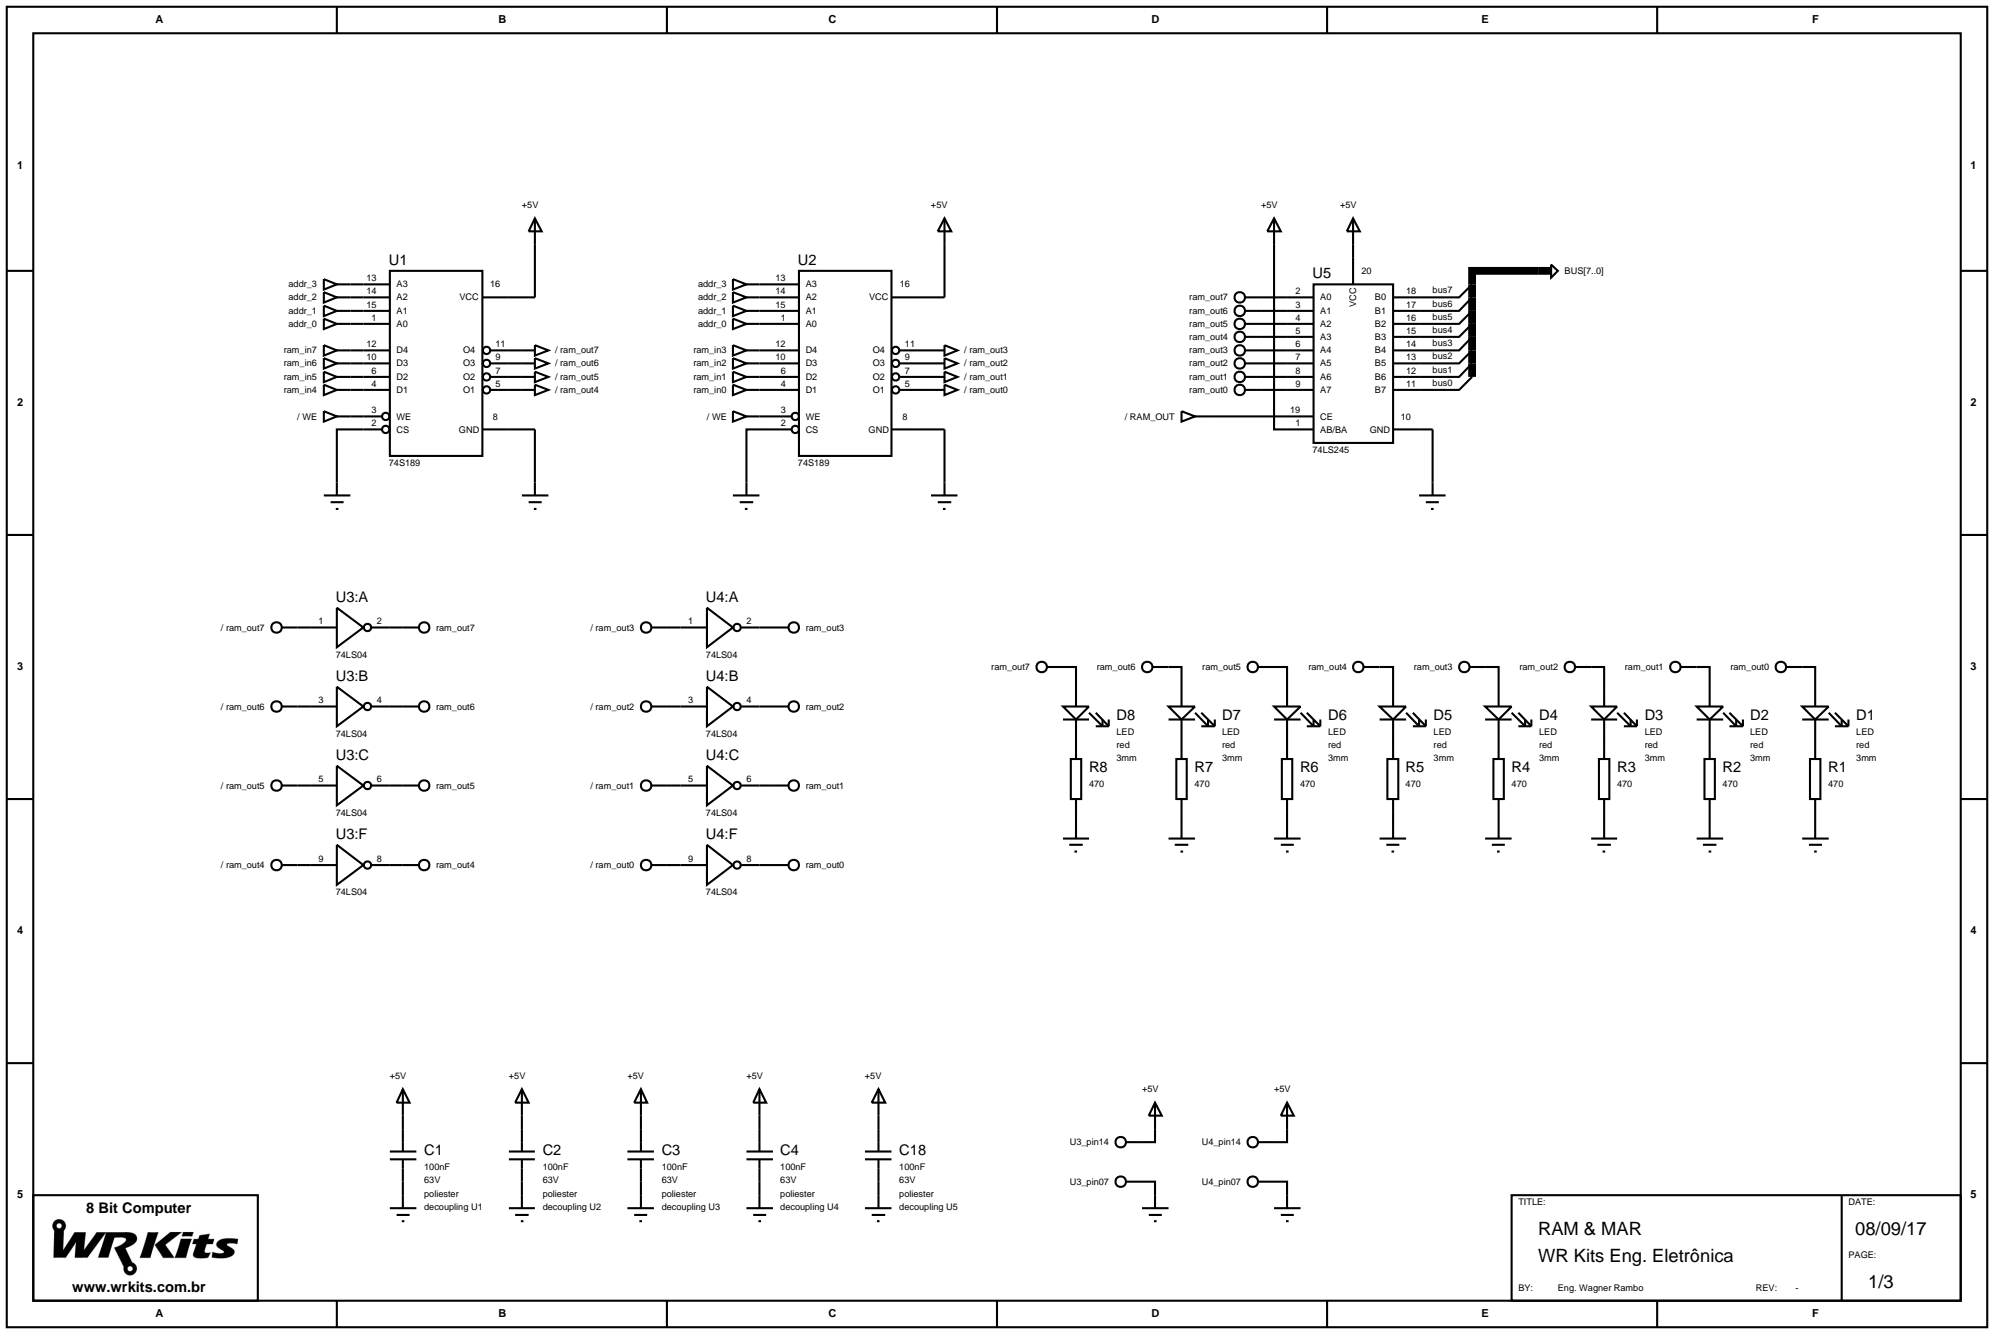
[picture p26: page 1]

TITLE:
RAM & MAR
WR Kits Eng. Eletrônica

www.wrkits.com.br
