ZaqueuCavalcante/egbit/(commit log)

2023-09-25 Add pdf files
    [ram_select_example.sch, truth_table.xlsx]
2023-10-15 Add timer
